Niatomi/portable-phone-osciloscope/README.md

# Portable Phone Osciloscope

Thesis on the creation of a portable USB oscilloscope.

Implemented electronic curcuit

Basicaly there is two mode:

1. Osciloscope mode

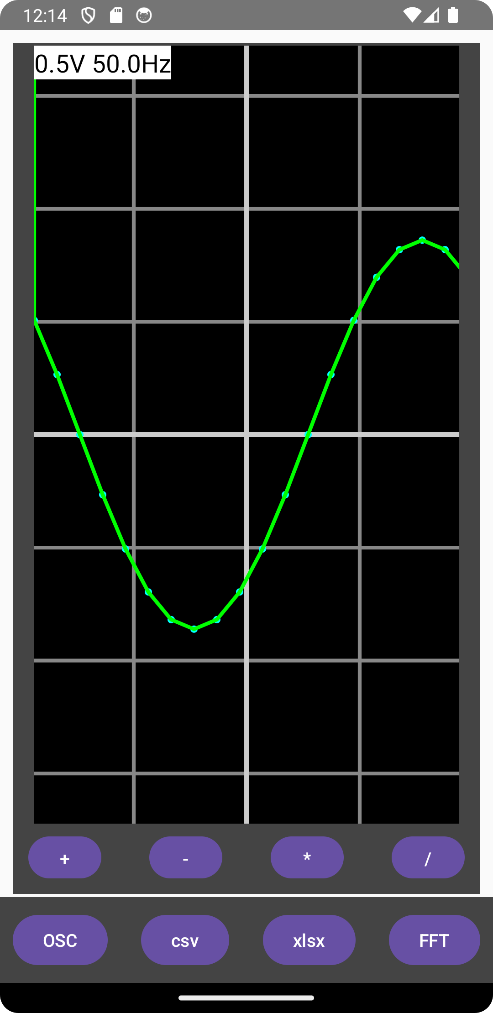
[picture p1: assets/1.png]
Osciloscope mode


2. FFT mode

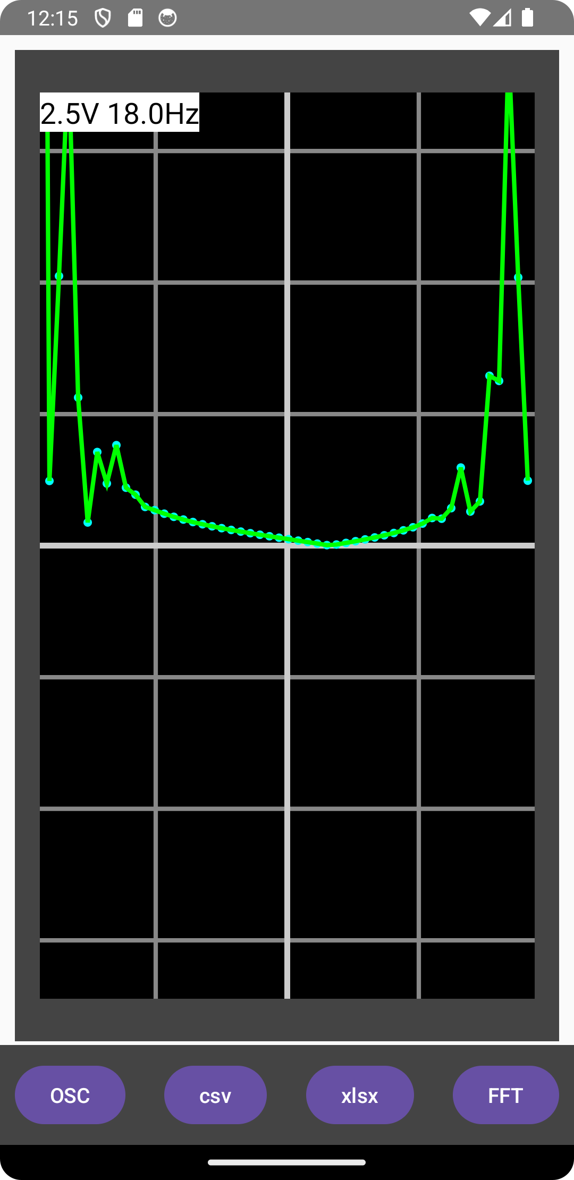
[picture p2: assets/2.png]
FFT mode
