Niatomi/portable-phone-osciloscope/logseq/pages/8.md

- https://dewesoft.com/ru/blog/types-of-adc-converters
  id:: 6646f040-7bf6-491e-b8a9-2d2daee1e0ae
