Niatomi/portable-phone-osciloscope/logseq/pages/Схема подключения микроконтроллера.md

- [[Схема подключения с измерительной цепью]]
- [[Схема подключения с UART преобразователем]]
