Niatomi/portable-phone-osciloscope/metrological-calculation/README.md

Первый делитель
1 / 2 = x * (10k / 20k)

Второй делитель
1 / 20 = V * (x / (10060  + x)) => x = 529.47
1 / 1 = V * ( 529.47 / (x  + 529.47)) => x = 0 (приравнять эту штуку к методической погрешности)

Третий делитель
https://www.ruselectronic.com/summator/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,%D0%9D%D0%B5%D0%B8%D0%BD%D0%B2%D0%B5%D1%80%D1%82%D0%B8%D1%80%D1%83%D1%8E%D1%89%D0%B8%D0%B9%20%D1%81%D1%83%D0%BC%D0%BC%D0%B0%D1%82%D0%BE%D1%80,-%D0%91%D0%B0%D0%B7%D0%BE%D0%B2%D0%B0%D1%8F%20%D1%81%D1%85%D0%B5%D0%BC%D0%B0%20%D0%B1%D1%83%D0%B4%D0%B5%D1%82

Максимальное входное напряжение - 0.5, максимальное выходное 1 В
Uвых = 1 В, U1 = 0.5, U2 = 0.5, R5 = 1 кОм
K1 = 1 / 1
K1 = R5 / x => R5 = 1 кОм

K2 = 1 / 10
K2 = R5 / x => x = 10 кОм

11 / 10 => R4 = 1100 Ом; R1 = 1000 Ом
