Niatomi/portable-phone-osciloscope/logseq/pages/DSO138.md

- DSO138 это карманный портативный осцилограф, который поставляется, либо в формате набора для самостоятельной сборки. Из плюсов такого подхода очевидная дешивизна, так как дополнительных затрат на сборку устройства компания не тратит.
- Максимум данное устройство может измерить 50 В сигнал с частотой дискретизации 200 кГц, что является плюсом, так как этих значений вплоне хватит для решения большиства задач при измерении напряжения [[17]].
- Из дополнительных функций DSO138 оборудован автоматической подстройкой пределов по частоте преобразования и входного напряжения.
- Питание устройства осуществляется при помощи внешнего источника питания на 9 В, либо при помощи блока питания, либо используя батарею крона. Поскольку DSO138 позиционируется как карманное решение, использование внешнего источника питания в данном случае является минусом, так как не всегда есть блок питания или даже доступ к источнику, а использование батарейки не делает практичным использование, так как её нужно заряжать зарядным устройством.
- Также осцилограф оборудован 2.4 дюма TFT экраном, который по нынешнем меркам является устревшим, как с позиции с технологии изготовления, так и с позиции восприятия данных, так как размер экрана того среднестатистического смартфона находится от 5 до 7 дюймов.
- На рисунке представлен собранный набор для осцилографа DSO138.
-
