Niatomi/portable-phone-osciloscope/logseq/pages/FNIRSI 1C15.md

- FNIRSI 1C15 является портативным универсальным осцилографом.
- Из выделяющихся опорных характеристик, на фоне рассмотренных осцилографов, он обладает полосой пропускания в 110 МГц, но при этом чуть меньшее максимальное входное напряжение в 40В [[20]].
- Из функций данное устройство может высчитывать в реальном времени статистические параметры, к примеру среднее значение, среднеквадратическое значение и т.д.. Но также стоит выделить странную реализацию сохранения сигнала, если в случае с [[DSO 068]] сигнал сохранялся в формат csv, который при дальнейшей обработке с использованием математических пакетов, довольно удобен при анализе и обраотке, то в FNIRSI 1C15 сохранение осуществляется путём записи картинки непосрдественно с TFT экрана, что в совокупности с его небольшими размерами и ручным переводом данных с картинки в число, не прибавляет удобства к использованию данного осцилографа
- Внешний вид FNIRSI 1C15 представлен на рисунке.
-
