Niatomi/portable-phone-osciloscope/logseq/pages/FNIRSI DPOX180H.md

- Двухканальный осциллограф FNiRSi DPOX180H сигнала позволяет отображать измеряемый сигнал в трех измерениях: амплитуда, время и интенсивность (распределение амплитуды по времени).
- Опорная характеристика полосы пропускания 180 МГц, максимальная величина входного напряжения 400В [[24]] .
- Для отобраения используется 2.5 TFT матрица
- Примечателен данный осцилограф тем, что на борту обладает функцией быстрого преобразования фурье, что позволяет получить спектр измеряемого сигнала.
- Внешний вид данного осцилографа представлен на рисунке.
-
