Niatomi/portable-phone-osciloscope/logseq/pages/HANTEK DSO-6074BC.md

- HANTEK DSO-6074BC осцилограф, который относится к классу устройств USB осцилографов, выполненных в форм факторе приставки.
- Относительно ранее рассмотренных осцилографов данное решение имеет довольно большие габариты 205 ммx 120 мм x 35 мм.
- Максимальное входное напряжение составляет 35 В, что не сравнимо даже с опорной характеристикой [[DSO138]], но при этом полоса пропускания составляет 70 МГц [[25]] .
- Данное устройство работает с приложением на внешнем устройстве. С которого можно производить фильтрацию, математические операции и т.д.. Такой подход является плюсом, так как нет привязки к дисплею.
-
