Niatomi/portable-phone-osciloscope/logseq/pages/OWON HDS2202S.md

- Осцилограф-мультиметр OWON HDS22002S в сравнении с предыдущими устройствами не выделяется широким набором функций для обработки сигнала. Из дополнительных функций в нём имеется только TrueRMS мультиметр и встроенный генератор сигналов специальной формы.
- Однако в сравненнии с ценовыми конкурентами его отличительной особенностью является наиболее широкая полоса пропускания, которая составляет 200 МГц, при максимальном напряжении входа 400 В [[23]].
- Внешний вид устройства представлен на рисунке
-
