Niatomi/portable-phone-osciloscope/logseq/pages/Квешенебл моментс.md

- ((663a9cfd-d353-4d09-9c25-ffef4bc72268)):
	- DONE [[Можно ли описать какие способы отладки использовались]]
	- DONE [[Можно ли в курсовой добавить объяснения почему выбран именно Android SDK, а не какой-то другой инструмент?]]
		- DONE [[К этому же вопросу, нужен ли анализ существующих инструментов типо React Native, Dart...]]
	- DONE [[Можно описывать ли описывать структуры хранения данных и паттерны]]
	- DONE [[Можно ли рассказать о формате передачи кадра?]]
	- DONE [[Можно ли в качестве источников использовать документацию к API?]]
		- Пример ссылки 133 страница - 134 источник - диссертация
		- ((663a7e74-4323-4b85-9dee-838098a09589))
	- DONE [[Можно ли добавить про инструменты разработки? (PlatformIO, Android Studio]]
	- DONE [[Можно ли описать структура проекта как файлы, типа, кто чем занимается, зачем нужен?]]
-
- ((663a9d09-63a3-4b8c-8e39-364c182f6277)):
	- DONE [[Можно ли в математику засунуть расчёт векторной графики для приложения?]]
	  id:: 663a7e74-4323-4b85-9dee-838098a09589
	  :LOGBOOK:
	  CLOCK: [2024-05-08 Wed 10:59:20]--[2024-05-08 Wed 10:59:21] =>  00:00:01
	  :END:
	- CANCELED [[Если приложение будет иметь несколько способов отображения (обычный осциллограф, функциональный вывод, АЧХ, фильтрация какойто составляющей) можно ли это внедрить в математику?]]
	  :LOGBOOK:
	  CLOCK: [2024-05-08 Wed 11:04:49]--[2024-05-08 Wed 11:04:50] =>  00:00:01
	  :END:
-
- Приложения код:
	- DONE Есть ли заготовка для таблицы с кодом?
		- Нет(
	- DONE Добавляем весь код или только тот, на который ссылаемся?
		- Какой угодно
	- На код можно сделать ссылку на гитхаб и показать во время защиты
-
- CANCELED [[Если мне нужно ввести свой собственный термин, как и куда?]]
  :LOGBOOK:
  CLOCK: [2024-05-08 Wed 01:27:14]--[2024-05-08 Wed 01:27:15] =>  00:00:01
  CLOCK: [2024-05-08 Wed 01:27:15]--[2024-05-08 Wed 01:27:16] =>  00:00:01
  :END:
	- DONE Так всё ещё можно как в предыдущей [методичке]([[Методичка]]) ?
	-
-
- [[Фактическая структура диплома]]
	- DONE [[Правильная ли структура литературного обзора?]]
	- DONE Ссылка на дальнейшее описание
		- Можно ли вот тут Описание делителя напряжения сделать ссылку, что о методах изменения входного напряжения будет описано далее?
		- Это го же касается  и
		- И соответственно про то что сигнал придётся брать по модулю через ОУ [схема модуля на ОУ](https://habr.com/ru/companies/ruvds/articles/652325/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)
		- Да
	- DONE В целом норм/не норм?
-
- CANCELED Что делать если в схеме несколько земель?
- CANCELED Слово ГОСТЫ можно в множественном числе? ((663fbce7-d2f5-4c2b-9e3c-d34130072230))
  :LOGBOOK:
  CLOCK: [2024-05-14 Tue 22:59:28]--[2024-05-14 Tue 22:59:28] =>  00:00:00
  CLOCK: [2024-05-14 Tue 22:59:29]
  :END:
	- DONE Сюда же вопрос, нужно ли этот момент пояснять, что я именно этими гостами пользовался?
- DONE Можно ли раскрыть более подробно тему работы, типо поставить тех задание?
- DONE [[Как оформить габаритный чертёж?]]
	- Вот это оформить с ссылкой на приложение или пофек можно и так картинкой оставить
	- ((6643b3d2-dbd5-4664-a6b5-57d0a078e533))
-
- DONE Мы руские друг друга в дюймах измеряем или в сантиметрах? ((66472a2f-47ac-4026-a4d5-c7771bc563bf))
	- Переводим в санитметры
- DONE Как оформить приложение для [печатной платы]([[Печатная плата]]) и нужно ли оно вообще как приложение?
	- Нужно показать на А3 все слои платы
- DONE Как обозначать вид общий именно где цифры?
	- И в методичке про это написано (или вк)
	- https://vk.com/im?sel=c142#:~:text=10%3A44-,%D0%A8%D0%B8%D1%84%D1%80%20%D0%B2%20%D1%87%D0%B5%D1%80%D1%82%D0%B5%D0%B6%D0%B0%D1%85,-%D0%BF%D1%80%D0%B8%D0%B2%D0%BE%D0%B4%D0%B8%D1%82%D1%81%D1%8F%20%D0%B2%20%D1%84%D0%BE%D1%80%D0%BC%D0%B0%D1%82%D0%B5
	- СамГТУ 12.03.01 040 015 003 (ноиер листа) ВО
- DONE На структурную можно ведь вывести предохранительную обвязку [[Разработка структурной схемы]]
	- DONE Здесь же вопрос, atmega328P работает на 20 MHz, максимальная частота АЦП 200 МГц, но между ними есть регистровый буфер, это ведь имеет смысл?
	- CANCELED STM32 посавить плату или ESP32
	- Просто нужно указать, что часть кадров может быть утеряна
- CANCELED Когда последняя дата сдачи последней бюрократии?
	- 26 мая
-
