Niatomi/portable-phone-osciloscope/logseq/pages/Методы обработки цифровых сигналов.md

- Одним из важных методов при обработке цифровых сигналов является преобразование Фурье. Преобразование Фурье переводит дискретный или непрерывный сигнал из временной в частотную область (по оси x вместо времени t следует откладывать частоту ω), причем полученные коэффициенты имеют комплексный вид. Модуль этих коэффициентов показывает распределение амплитуд по частотам в сигнале, а аргумент – распределение фазовых сдвигов по частотам [[10]].
-
