Niatomi/portable-phone-osciloscope/logseq/pages/План капкан.md

- DONE Проработать [[Формат передачи данных]]
- DONE Реализовать Serial подлючение к телефону
- DONE Сделать обёрточные функци под байтовый фрейм
- DONE  [#A] [[Реализовать базовый компонент отрисовки данных формата XY]]
  :LOGBOOK:
  CLOCK: [2024-05-07 Tue 23:32:21]--[2024-05-07 Tue 23:32:23] =>  00:00:02
  CLOCK: [2024-05-07 Tue 23:32:24]--[2024-05-07 Tue 23:32:25] =>  00:00:01
  :END:
- TODO  [#A] Реализовать алгоритмы отображения сигнала
	- DONE Осцилограф
	- DONE АЧХ
	- TODO Фильтрация составляющией
- DONE [#B] Переделать схему для работы с отрицательными сигналами
	- DONE Принципиальная схема
	- DONE Спецификация
- DONE [#C] В соответсвии с этой схемой сделать ультра мелкую плату в [Dip Trace](https://diptrace.com/rus/)
	- DONE [#C] Для этой схемы сделать корпус
- TODO [#C] БЮРОКАРААААТИИИЯЯЯ
	- DONE [[Титульный лист]]
	- DONE [[Реферат]]
	- DONE [[Введение]]
	- DONE [[Теоретическое исследование портативный устройств измерения временных сигналов]]
		- DONE [[Литературный обзор]]
		- DONE [[Итог анализа литературного обзора]]
		- DONE [[Постановка задачи]]
	- DONE [[Разработка методики измерения параметров временных сигналов в цифровой электронике]]
		- DONE [[Преобразование аналогового сигнала в цифровой]]
		- DONE [[Способы изменения масштаба дискретизации]]
		- DONE [[Метод изменения входного напряжения]]
		- DONE [[Методы смещения сигнала]]
		- DONE [[Методы обработки цифровых сигналов]]
		  :LOGBOOK:
		  CLOCK: [2024-05-16 Thu 20:41:56]--[2024-05-16 Thu 20:41:56] =>  00:00:00
		  CLOCK: [2024-05-16 Thu 20:41:57]--[2024-05-16 Thu 20:41:57] =>  00:00:00
		  CLOCK: [2024-05-16 Thu 20:41:57]--[2024-05-17 Fri 12:51:39] =>  16:09:42
		  :END:
		- DONE [[Порядок действий обработки аналогового сигнала]]
	- TODO [[Разработка портативного устройства для измерения параметров временных сигналов]]
		- DONE [[Постановка задачи]]
		- DONE [[Разработка структурной схемы]]
		  :LOGBOOK:
		  CLOCK: [2024-05-12 Sun 16:35:29]--[2024-05-12 Sun 16:35:30] =>  00:00:01
		  :END:
		- DONE [[Разработка принципиальной схемы]]
		- DONE [[Разработка печатной платы]]
		  :LOGBOOK:
		  CLOCK: [2024-05-12 Sun 17:07:12]--[2024-05-14 Tue 22:58:23] =>  53:51:11
		  :END:
			- DONE Сделать плату в DipTrace
			- DONE Написать текст
			  :LOGBOOK:
			  CLOCK: [2024-05-14 Tue 04:10:12]
			  :END:
		- DONE [[Разработка корпуса устройства]]
			- DONE Сделать корпус
			- DONE Написать текст
		- DONE [[Разработка математического обеспечения]]
		- TODO [[Разработка программного обеспечения]]
		- TODO [[Эксперементальное исследование разработанного устройства]]
	- DONE [[Заключение]]
	- TODO [[Список использованных источников]]
	- TODO [[Приложения]]
		- DONE [[Принципиальная схема]]
		- DONE [[Перечень элементов]]
		- DONE [[Печатная плата]]
		- DOING [[Корпус]]
		  :LOGBOOK:
		  CLOCK: [2024-05-17 Fri 14:13:02]
		  :END:
		- TODO [[Исходный код]]
