Niatomi/portable-phone-osciloscope/logseq/pages/Порядок действий обработки аналогового сигнала.md

- На основе всего описанного выше, для обработки аналогового сигнала следует соблюсти последовательность преобразования измерямой величины:
	- Преобразовать измерямый сигнал к пределу измерения аналогового-цифрового преобразователя, используя связку делитель с сумматором;
	  logseq.order-list-type:: number
	- Настроить масштаб частоты дискретизации под частоту измеряемого сигнала;
	  logseq.order-list-type:: number
	- Преобразованный сигнал при помощи АЦП перевести в цифровое дискретное значение;
	  logseq.order-list-type:: number
	- Получение значение передать на устройство ввода/вывода, где содержится вся серия дискретных данных;
	  logseq.order-list-type:: number
