Niatomi/portable-phone-osciloscope/logseq/pages/Разработка математического обеспечения.md

- [[Реализация представления кадра данных]]
- [Алгоритм отрисовки данных]([[XYCanvas]])
- [[Реализация АЧХ представления сигнала]]
