Niatomi/portable-phone-osciloscope/logseq/pages/Схема подключения с UART преобразователем.md

- Для взаимодействие с внешними устройствами к миконтроллеру подключен преобразователь интерфейсов FT232RL, подключение к которому осуществляется при помощи штекерный вывод micro USB.
- FT232RL позволяет переводит данные с интерфеса UART микронтроллера на USB, так и обратно. Внешнее подключаемое устройство помимо обмена данных с ESP-12S будет также осуществлять функцию источника питания, через тот же интерфейс USB
- Также плата имеет кнопку SB1, которая перезагрузит микроконтроллер. Отключение платы осуществляется либо физическим способом, путём отключения устройства, либо программным - отключение функции OTG на уровене внешнего подключаемого устройства.
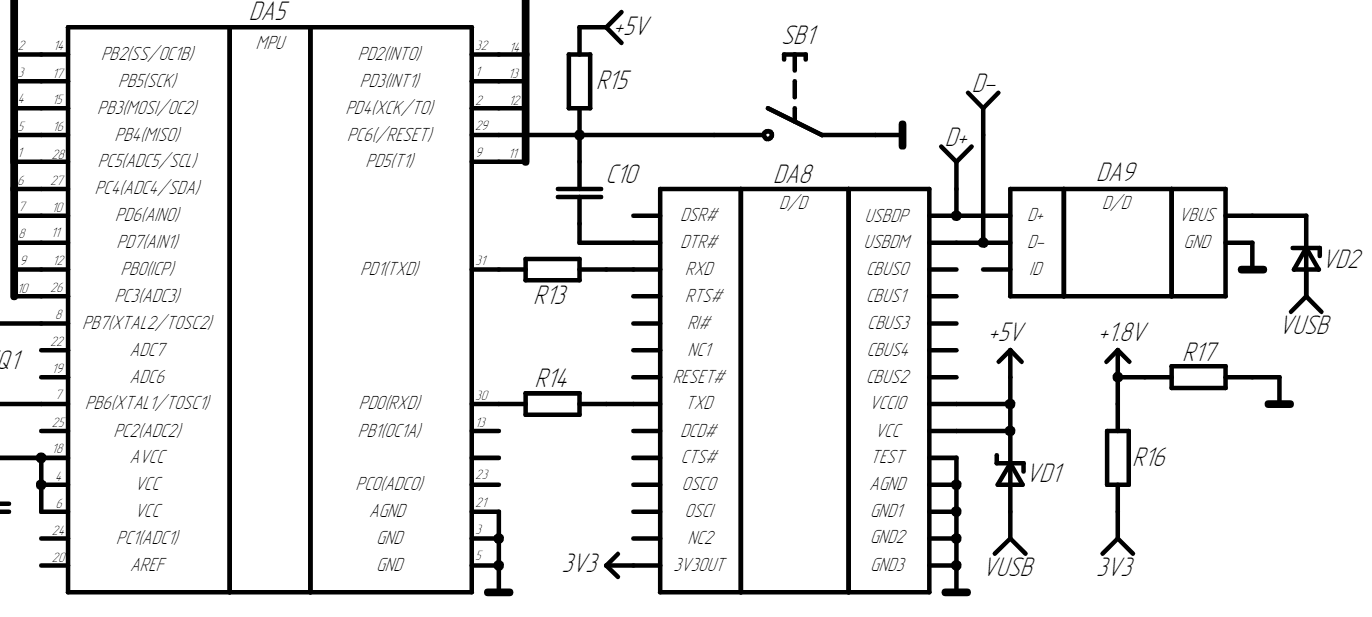
[picture p6: logseq/assets/image_1715514424193_0.png]
-
