Niatomi/portable-phone-osciloscope/logseq/pages/DSO 068.md

- Портативный карманный осцилограф от ранее рассмотренной компании, хоть и имеет модельное обозначение меньше, чем рассмотренные осцилографы, но при этом является более мощной с точки зрения опорных характеристик.
- Его максимальная частота полосы пропускания составляет 3 МГц, при этом максимальное входное напряжение зависит от щупа. С щупом 1:1 максимальное входное напряжение составляет 50 В, а при использовании щупа 1:10 оно возрастает до 400 В [[21]] .
- Использующийся здесь жидкокристалический дисплей явно самый худший из рассмотренных, к тому же он составляет всего 2 дюйма. Но представление данных в этом устройстве не ограничивается одним лишь экраном, ведь измеряемые данные можно записать на устройстве и перенести в формате CSV на компьютер.
- Также из минусов устройство имеет большие габариты, они составляют 140мм X 70мм X 30мм
- Внешний вид DSO 068 представлен на рисунке.
- JYE Tech DSO068 Oscilloscope DIY Kit
