Niatomi/portable-phone-osciloscope/logseq/pages/DSO-TC2.md

- DSO-TC2 является мультифункциональным цифровым осцилографом. В данном устройстве реализовано множество инструментов через интрефейсные разъёмы, к примеру ШИМ-генератор, ZIF-панель, вольтметр MMXC и т.д.
- Здесь уже используется встроенная литиевая батарея на 1500 мАч, что является плюсом.
- Величина полосы пропускания частот осталась на равне с ранее рассмотренными моделями, но при этом увеличилась максимальная амплитуда напряжения до 400 В [[19]].
- Но проблема использования той же самой 2.4 TFT матрицы никуда не делась.
- Внешний вид DSO-TC2 представлен на рисунке.
-
