Niatomi/portable-phone-osciloscope/logseq/pages/Итог анализа литературного обзора.md

- Проанализровав все основные решения в поставленном ценовом диапазоне, выявлены опорные характеристики, которые свойственны осцилографам на текущий момент.
- Для полосы пропускания минимальное значение составляет 200 кГц, максимальная 200 МГц. Устройства обладающие полосой пропускания больше 200 МГц относятся к классу лабораторных осцилографов, которые соответственно имеют большую стоимость, поэтому в данном разделе они не были упомянуты.
- Для входного напряжения сигнала предел варьируется между 50 В и 400 В.
- Общий минус, применимый к каждому из устройств, связан с маленьким размером и качеством матрицы отображения данных. Диагональ экрана преимущественно обладает размером 2.4 дюйма, а сами матрицы выполнены по технологии TFT. Поэтому пользовательский опыт в таком случае оставляет желать лучшего.
- Часть из рассмотренных решений, обладает полезными функциями, например быстрое преобразование Фурье, математические функции над сигналами или экспорт в удобный формат. Такие функции бывают крайне полезны при измерении сигналов.
- Также на примере осцилографа от Hantek можно увидеть, что использование измерительной схемы без использования интерфейсов ввода/вывода встроенных непосредственно в устройство вполне применимо, взамен их в качестве интерфейса взаимодействия выступает внешнее устройство.
