Niatomi/portable-phone-osciloscope/logseq/pages/Литературный обзор.md

- На данный момент на рынке портативных осцилографов представлено множество уже готовых решений. Различаются они набором функционала и соответственно чем выше цена устройства, чем больше функций оно имеет на борту. Рассматриваемые в данной главе устройстве находятся в пределе ценовой стоимости до 20000 рублей на момент написания данной выпускной квалификационной работы. Именно такой диапазон выбран потому что данная ценовая категория наиболее востребована и по итогу разработанное устройство должно составить конкуренцию в данном сегменте.
-
- [[DSO138]]
- [[DSO Shell]]
- [[DSO-TC2]]
- [[DSO 068]]
- [[FNIRSI 1C15]]
- [[MiniDSO DS211]]
- [[FNIRSI DPOX180H]]
- [[OWON HDS2202S]]
- [[HANTEK DSO-6074BC]]
