Niatomi/portable-phone-osciloscope/logseq/pages/Постановка задачи.md

- На основании всех решений уже имеющихся на момент написания выпускной квалификационной работы следует составить техническое задание, которое наложит ограничения на измеряемую величину, технические характиристики и особенности взаимодействия.
- Основополагающая идея разрабатываемого устройства заключается в портативности и компактности. Данной цели возможно добится используя следующие пункты:
	- Устройство должно использовать внешнее устройство ввода/вывода для отображения данных;
	- Это же внешнее устройство должно использоваться в качестве источника питания
	- Компоненты измерительной системы должны быть компактными и энергоэффективными
	- Габаритные размеры полученного устройства не должны превышать размеры среднестатистического смартфона, что в районе от 5 до 7 дюймов.
	  id:: 66472a2f-47ac-4026-a4d5-c7771bc563bf
- На измеряемый сигнал также имеются следующие ограничения:
	- Абсолютная величиная напряжения должна быть меньше 100 В, так как не предполагается использовать разрабатываемый осцилограф, в целях измерения силовой электроники, где обычное напряжение составляет более 100 В.
	- Частота сигнала должна быть не более 200 МГц.
- На программном уровне должны быть реализованы следующие функции:
	- Представление сигнала;
	- Представление спектра сигнала;
	- Применение математических функций к полученным данным;
	- Импортирование измеренных данных в форматы CSV/XLSX;
- Также для структурированной и согласованной работы между устройством пользователя и измерительной системой следует создать единую структру передачи дискретного отсчёта.
