Niatomi/portable-phone-osciloscope/logseq/pages/1.md

- И.Н. Зайцева, Э.И. Исакович, Н.А. Ярлыкова Радиоизмерения и измерительные приборы: осциллографы. Осциллографические измерения: учебно-методическое пособие. – Елец: Елецкий государственный университет им. И.А. Бунина, 2017. – 96 с
  id:: 66463b8e-3c2d-447e-8e59-d44b0099ba4c
