Niatomi/portable-phone-osciloscope/logseq/pages/10.md

- Преобразование измерительных сигналов: практикум / А.В. Бочкарев, Р.Т. Сайфуллин. – Самара: Самар. гос. техн. ун-т, 2022. – 150 с.
  id:: 66471382-ade9-4dab-a1d1-b92a50d67d31
