Niatomi/portable-phone-osciloscope/logseq/pages/11.md

- Статья http://www.dspa.ru/articles/year2019/jour19_2/art19_2_10.pdf
  id:: 6647180b-f64a-4029-9207-7c54a19812c4
