Niatomi/portable-phone-osciloscope/logseq/pages/2.md

- М 47 Цифровые измерительные устройства. Часть 1. – Аналогоцифровые преобразователи: Учеб. пособ. / В.С. Мелентьев, П.К. Ланге, К.Л. Куликовский. – Самара: Самар. гос. техн. ун-т, 2012. – 209 с.: ил.
  id:: 6646e34e-37ec-49d5-8227-cade29b075a3
