Niatomi/portable-phone-osciloscope/logseq/pages/3.md

- Одинец А.И., Науменко А.П. Цифровые устройства: АЦП и ЦАП: Учеб. пособие. – Омск: Изд-во
  id:: 6646e461-7db6-4322-9953-b1678678ca85
  ИРСИД, 2006.- 48 с.
