Niatomi/portable-phone-osciloscope/logseq/pages/5.md

- Аналого-цифровые и цифроаналоговые преобразователи: методические указания к выполнению лабораторной работы по дисциплине «Электротехника, электроника и схемотехника» / ЮгоЗап. гос. ун-т; сост. В.И. Иванов. - Курск: ЮЗГУ, 2016. 19 е.: ил. 11,табл. 1.-Библиогр.: с. 19.
  id:: 6646e88e-c93c-440d-bcad-268af000d553
