Niatomi/portable-phone-osciloscope/logseq/pages/6.md

- Кестер, У. Аналого-цифровое преобразование / У. Кестер. – М.: Техносфера, 2007. – 1015 с.
  id:: 6646ec3b-90fb-4aae-9b18-e733c07c461a
