Niatomi/portable-phone-osciloscope/logseq/pages/7.md

- Ратхор Т.С. Цифровые измерения. АЦП/ЦАП / Пер. с англ. – 2-е изд., доп. – М.:
  id:: 6646eea2-9a7b-45a2-8508-e902b2bde6a2
  Техносфера, 2006. – 391 с.
