Niatomi/portable-phone-osciloscope/logseq/pages/Введение.md

- В данной выпускной квалификационной работе рассматривается разработка портативного устройства для измерения параметров временных сигналов, предназначенного для использования в связке с пользовательским устройством ввода/вывода, по типу телефона или планшета.
- Устройство для измерения параметров временных сигналов относится к категории измерительных приборов – осциллографы.
- Сами осциллографы делятся на две подкатегории – цифровые, аналоговые [[1]].
- Различие их заключается в способе обработки сигнала, в аналоговых осциллографах все преобразования над сигналом происходят напрямую при помощи сборки электронных блоков, их недостатки – ограниченные возможности по обработке и низкая точность. У цифровых за обработку отвечает чаще всего связка аналогово-цифрового преобразователя, захватывающего значение
  сигнала в определённые интервалы времени, а обработка этих значений происходит
  при помощи программного обеспечения микроконтроллера, их минусом является
  большая стоимость по отношению к аналоговым осциллографам.
- Применение осциллографов универсально – от использования при ремонте бытовой техники до анализа радиоэлектронных компонентов, поэтому осциллографы довольно широко распространены в сфере электротехники.
