Niatomi/portable-phone-osciloscope/logseq/pages/Печатная плата.md

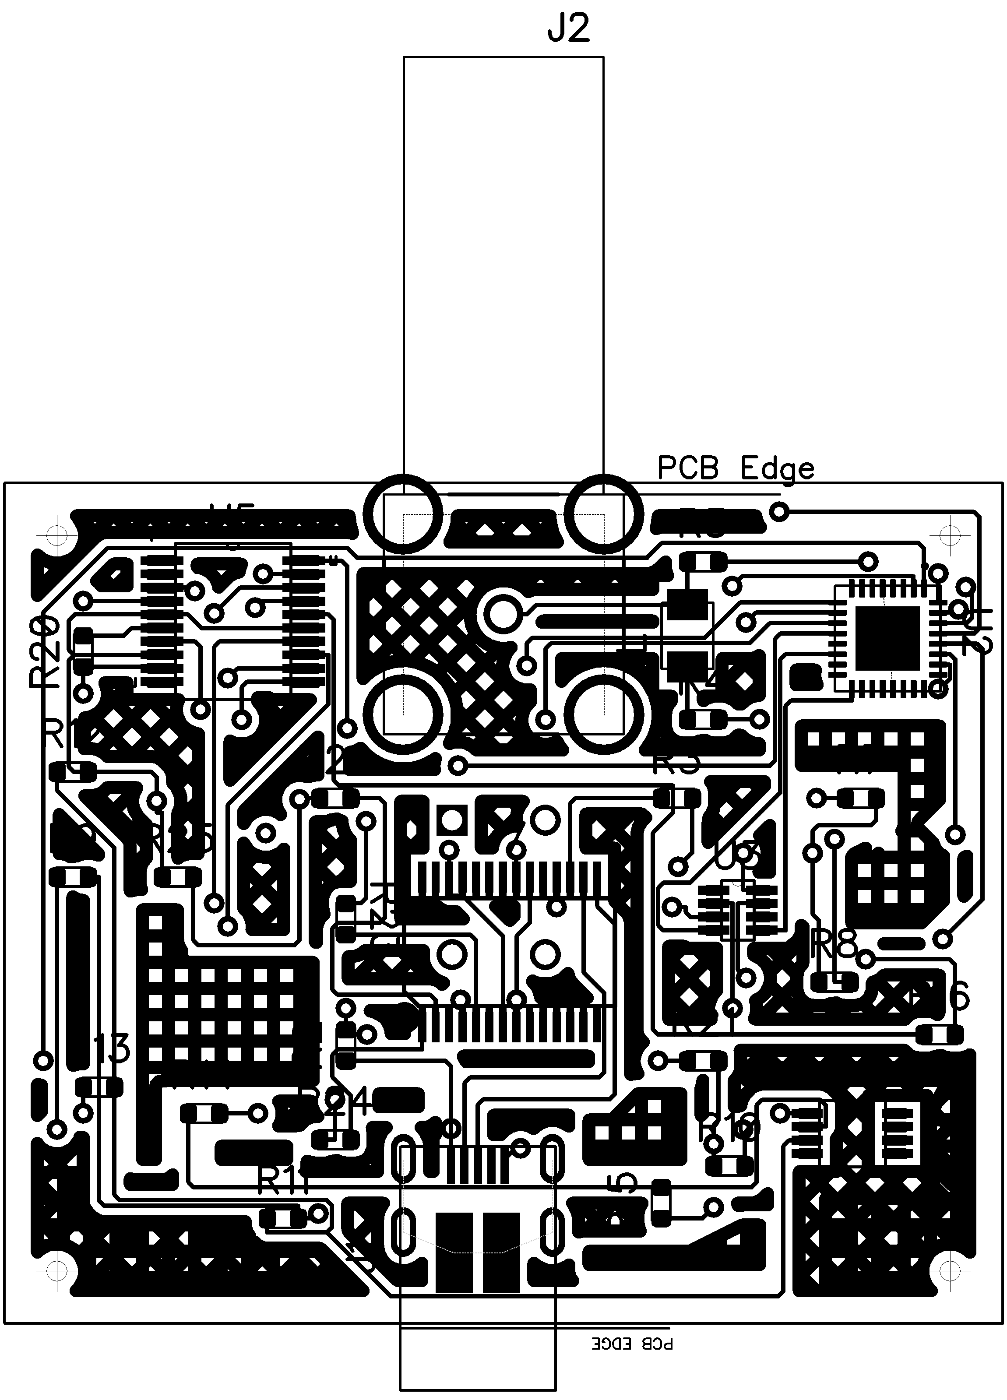
[picture p11: logseq/assets/Печатная_плата_1715940428006_0.png]
Печатная плата.png
-
