Niatomi/portable-phone-osciloscope/logseq/pages/Принципиальная схема.md

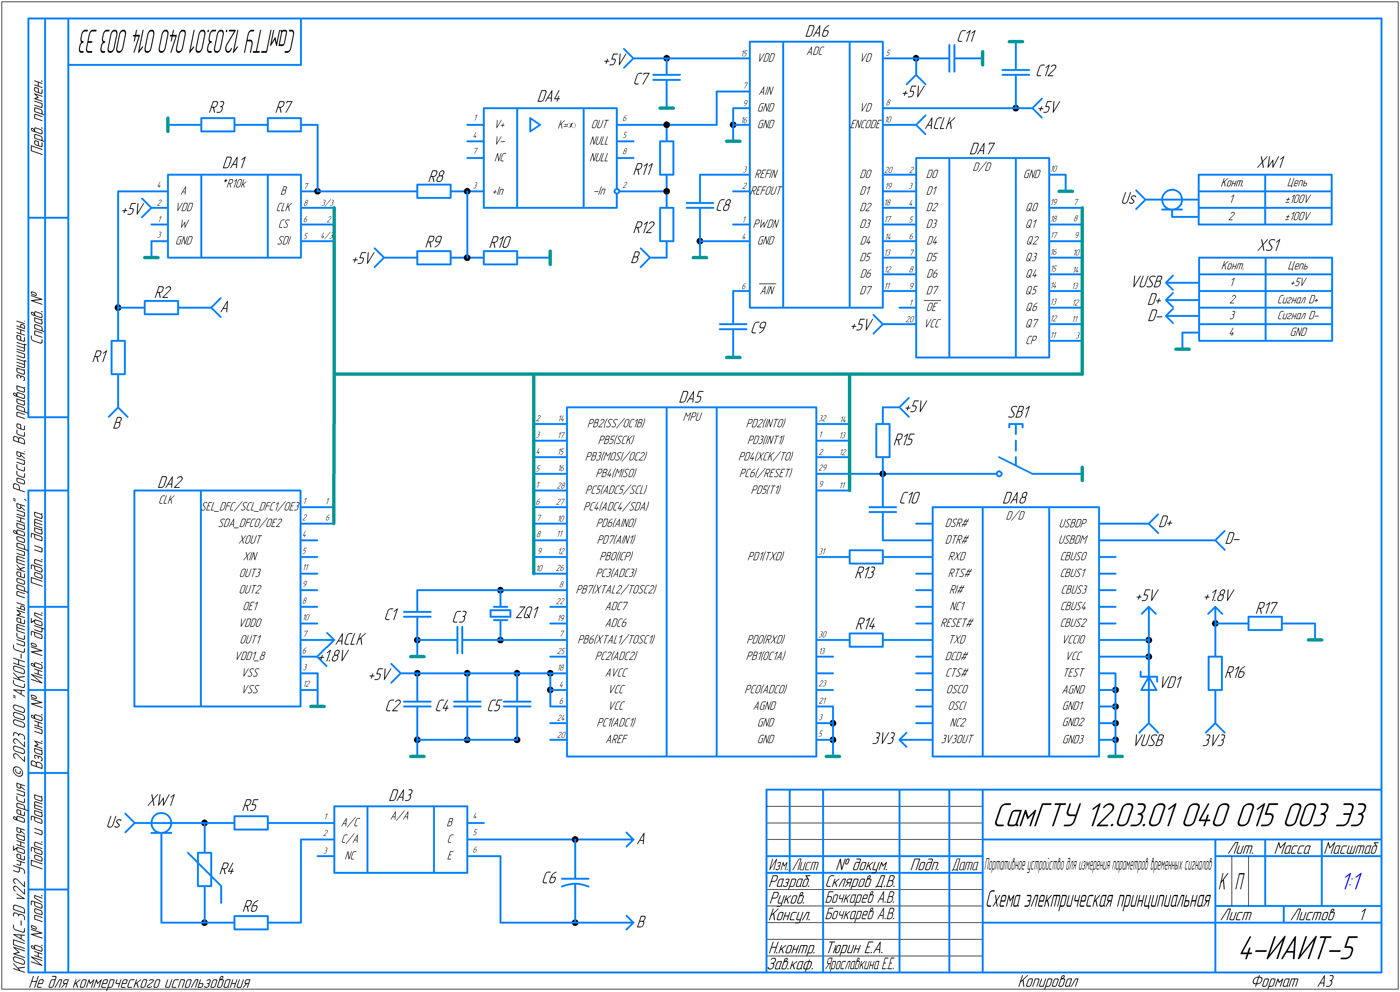
[picture p12: logseq/assets/Принципиальная_схема_1715940993965_0.png]
Принципиальная схема.png
-
