Niatomi/portable-phone-osciloscope/logseq/pages/Реферат.md

- Выпускная квалификационная работа _ страниц, _ рисунка, _ таблицы, _ источников, _ приложения, _ формулы.
-
- АНАЛОГОВО-ЦИФРОВОЙ
  ПРЕОБРАЗОВАТЕЛЬ, МИКРОКОНТРОЛЛЕР, ОБРАБОТКА СИГНАЛОВ, ОСЦИЛОГРАФ, ПОРТАТИВНОЕ
  УСТРОЙСТВО, СИГНАЛЫ
-
- Целью курсового проекта является разработка портативного устройства для измерения параметров временных сигналов.
- 3. [[Разработка портативного устройства для измерения параметров временных сигналов]]
- В первой части выпускной квалификационной работы преставлено теоретическое исследование похожих на разрабатываемое устройство решений.
- Во второй части описана методика измерения параметров временных сигналов в цифровой электронике
- Третья часть включает в себя процесс разработки устройства.
