Niatomi/portable-phone-osciloscope/logseq/pages/Структура взаимодействия.md

- В структуре взаимодействия микроконтроллера и клиентского приложения самым слабым, с точки зрения вычислительных мощностей, является микроконтроллер. Поэтому он будет реализовывать функции устройства, которое проксирует АЦП и выдаёт данные на выход [[15]] .
- Так как передаваемые данные очень важны для действительного представления данных пользователю, то выбрана следующий [[Формат передачи данных]] и сама единица данных.
