Niatomi/portable-phone-osciloscope/logseq/pages/Фактическая структура диплома.md

- Тема: Портативное устройство для измерения параметров временных сигналов
-
- [[Титульный лист]]
- [[Реферат]]
- [[Введение]]
- [[Содержание]]
- 1. [[Теоретическое исследование портативный устройств измерения временных сигналов]]
	- [[Литературный обзор]]
	- [[Итог анализа литературного обзора]]
	- [[Постановка задачи]]
- 2. [[Разработка методики измерения параметров временных сигналов в цифровой электронике]]
	- [[Преобразование аналогового сигнала в цифровой]]
	- [[Способы изменения масштаба дискретизации]]
	- [[Метод изменения входного напряжения]]
	- [[Методы смещения сигнала]]
	- [[Методы обработки цифровых сигналов]]
	- [[Порядок действий обработки аналогового сигнала]]
- 3. [[Разработка портативного устройства для измерения параметров временных сигналов]]
	- [[Разработка структурной схемы]]
	- [[Разработка принципиальной схемы]]
	- [[Разработка печатной платы]]
	- [[Разработка корпуса устройства]]
	- [[Разработка математического обеспечения]]
	  id:: 663a9d09-63a3-4b8c-8e39-364c182f6277
	- [[Разработка программного обеспечения]]
	  id:: 663a9cfd-d353-4d09-9c25-ffef4bc72268
	- [[Эксперементальное исследование разработанного устройства]]
	  id:: 663a995f-07b6-4ca6-892e-067e713fab81
- [[Заключение]]
- [[Список использованных источников]]
- [[Приложения]]
	- Принципиальная схема
	- Перечень элементов
	- [[Печатная плата]]
	- [[Корпус]]
	- Исходный код
