Niatomi/portable-phone-osciloscope/logseq/pages/Как оформить габаритный чертёж%3F.md

- Отдельно по три вида на каждую часть для приложений
- И в рисунках можно это добавить как демонстрацию габаритов
