Niatomi/portable-phone-osciloscope/logseq/pages/Разработка принципиальной схемы.md

- CANCELED Для реализации принципиальной схемы устройства используется Компас 22 версии. В качестве стандарта условных графических обозначений используются ГОСТ 2.743-91 и ГОСТ 2.755-87.
  id:: 663fbce7-d2f5-4c2b-9e3c-d34130072230
-
- [[Схема входной обвязки]]
- [[Схема входных делителей]]
- [[Схема подключения аналогово-цифрового преобразователя]]
- [[Схема подключения микроконтроллера]]
