Niatomi/portable-phone-osciloscope/logseq/pages/Apache Cordova.md

- Среда разработки мобильных приложений запускает обработку JavaScript/HTML/CSS кода в WebView и добавляет системные вызовы для взаимодействия со специфичными для определённых операционных систем интерфейсами.
- Данная платформа на данный момент не поддерживается создателем, но всё ещё популярна и используется в таким продуктах как [1C-Битрикс](https://dev.1c-bitrix.ru/learning/course/index.php?COURSE_ID=80&LESSON_ID=7757).
- Экспериментальное использование [Serial библиотеки](https://github.com/WolfWalter/cordova-plugin-usb-serial) выявило, что пример из документации для этой библиотеки не работает на новых версиях Android.
