Niatomi/portable-phone-osciloscope/logseq/pages/Ionic и PhoneGap.md

- Ionic и PhoneGap являются ответвлениями проекта Apache Cordova cо значительными доработками под новые версии Android и iOS.
- Идентичные эксперименты с Serial библеотеками, как в случае Apache Cordova, не привели к каким-либо положительным резльутатам. Приложения также не запускались, либо инициализировались, но без соединения с микроконтроллером.
