Niatomi/portable-phone-osciloscope/logseq/pages/Jetpack Compose.md

- Jetpack Compose инструмент является нативным SDK для Android устройств, но также исходный код ПО может быть скомпилирован под iOS устройства.
- Так как это нативный инструмент разработки взаимодействие с устройствами Serial порта на Android устройствах происходят напрямую через [TTY](https://itsfoss.com/what-is-tty-in-linux/) обращаемого устройства.
- Сам инструмент поддерживается как компанией разработчиком Google, так и сообществом.
- В ходе экспериментов с Serial портом минусов при отладке не выявлено. Данный SDK корректно прошёл все этап экспериментальной программы.
