Niatomi/portable-phone-osciloscope/logseq/pages/React Native.md

- React Native SDK для создания кроссплатформенных приложений, благодаря которой написанное ПО будет работать как и на устройствах под управлением операционной системы Anroid, так и на устройствах под управлением iOS.
- Сам инструмент поддерживается компанием разработчиком и мировым сообществом, об этом говорит колличество и периодичность выхода новых версий на [странице релизов](https://github.com/facebook/react-native/releases)
- Эксперимент с использованием библиотеки [Serial порта](https://www.npmjs.com/package/serialport) с примером из документации в React Native выявил, что подключение к микроконтроллеру срабатывает с некоторой периодичностью, а само приложение после установления соединения начинает нестабильно работать.
