Niatomi/portable-phone-osciloscope/logseq/pages/Заключение.md

- Можно основать на заключении курсовой, НО дополнить результатами исследования 2 главы (какой метод или алгоритмы обработки были выбраны для разрабатываемой системы), а также дополнениями (если они возникли) по сравнению с курсовой из 3 главы (если делали печтаную плоту - можно указать ее гарабирты, если корпус - тоже габариты и особенности)
-
- Данная работа была направлена на разработку gортативного устройства для измерения параметров временных сигналов. В работе были описаны общие принципы дискретного и аналогово измерения сигналов при помощи осциллографов. Описаны основные компоненты, использующиеся при построении осциллографов, а именно делители, аналогово-цифровые преобразователи, мультиплексоры, буферные регистры, а также интерфейсы вывода данных пользователю.  Создана и описана структурная схема разработанного устройства. Реализована принципиальная электрическая схема устройствадля анализа сигналов, способного работать с поддерживающими USB устройствами.  Спроектирована печатная плата на основе принципиальной, а также создан корпус устройства.
