Niatomi/portable-phone-osciloscope/logseq/pages/Схема подключения с измерительной цепью.md

- Шина на которой подключены все управляемые устройства ведётся к микроконтроллеру, с которого и ведётся всё дальнейшее чтение данных с буферного регистра и управление периферийными устройствами.
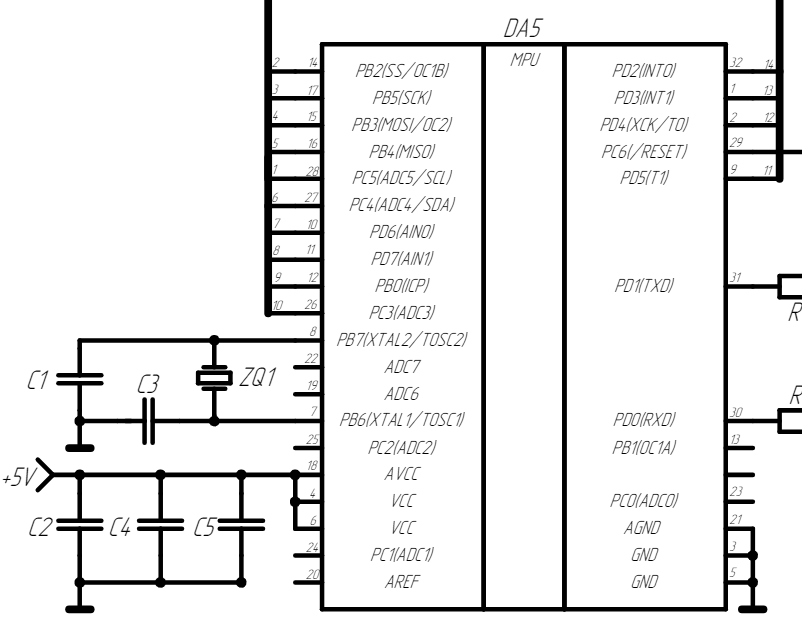
[picture p29: logseq/assets/image_1715514192946_0.png]
- 
-
