Niatomi/portable-phone-osciloscope/logseq/pages/Если мне нужно ввести свой собственный термин, как и куда%3F.md

- [[Фрейм]]
-
- Если нужно ввести свой собственный термин, на него можно сделать описание непосрдественно в тексте
-
