Niatomi/portable-phone-osciloscope/logseq/pages/Можно ли в математику засунуть расчёт векторной графики для приложения%3F.md

- Можно описать с позиции развертки осцилографа
