Niatomi/portable-phone-osciloscope/logseq/pages/Можно ли описать структура проекта как файлы, типа, кто чем занимается, зачем нужен%3F.md

- Можно, но не чтоб половина всего текста ))
