Niatomi/portable-phone-osciloscope/logseq/pages/Правильная ли структура литературного обзора%3F.md

- Пример в диссере - 22 страница
- В целом это не регламентировано
- Если нужно сослаться на товар, то можно ссылкой на сайт сделать отсылку на товар
-
- `hantek` вот эти устройства сюда можно
- `LCard` быстодействующий АЦП``
