Niatomi/portable-phone-osciloscope/logseq/pages/Разработка ПО микрокнтроллера.md

- Исходный код ПО для микроконтроллера написан на языках программирования С и C++.
- При разработке ПО для микроконтроллера был выбран инструмент [PlatformIO](https://platformio.org/), который во многом упрощает работу со сторонними библиотеками, что поможет возможной вариативности компонентов АЦП.
