Niatomi/portable-phone-osciloscope/logseq/pages/Разработка программного обеспечения.md

- [[Разработка ПО микрокнтроллера]]
- [[Разработка ПО клиентского приложения]]
- [[Структура взаимодействия]]
- [[Создание и отладка ПО при разработке]]
