Niatomi/portable-phone-osciloscope/logseq/pages/Создание и отладка ПО при разработке.md

- В качестве инструмента [[Разработка ПО микрокнтроллера]] использовалась среда разработки vscode и отладчик gdb
- В качестве инструмента [[Разработка ПО клиентского приложения]] использовался Android Studio и встроенный в него отладчик
