Niatomi/portable-phone-osciloscope/logseq/pages/PhoneClient.md

## Клиентское приложение просмотра измерений
id:: 663a8778-5327-4917-97cb-f06bf426e31d
- [[Общие положения для подпроекта для клиентского приложения]]
-
- [[./java/.../phoneclient]]
