Niatomi/portable-phone-osciloscope/logseq/pages/ProxyADCApp.md

## Проксирующее АЦП приложение для микроконтроллера
id:: 663a87a4-aab0-4c55-b605-84bffbf7fc4b
- [[Общие положения для подпроекта для микроконтроллера]]
-
- [[src]] - Исходный код
-
