Niatomi/portable-phone-osciloscope/logseq/pages/screens.md

- Каждый скрин представляется из себя читателя [[RingBuffer]]
- Преобразование над данными фрейма производятся только внутри структур данных скрина
	- Изменять данные непосредственно в кольцевом буфере !!НЕЛЬЗЯ
	-
