Niatomi/portable-phone-osciloscope/logseq/pages/Выбор (или разработка) методики изменеия (или обработки) %5F%5F%5F (название измеряемого параметра, или видов обработки и т.п.).md

- Пример:
	- Выбор методики измерения расстояния
	- Разработка методики обработки сигналов в ___ (название разрабатываемой системы)
-
- В этом разеделе говорим (не обязательно по обоим пунктам):
	- Методы (или методики) (и/или разработанные самостоятельно метод) измерения интересующего нас параметра, т.е. схема подключения устройства, порядок действий для получения нужного параметра из измеряемого сигнала.
		- Пример: Для дальномера это может быть формулы расчёта расстояния по задержке звука при различных способах - теневом, это и т.д..
	- Существующее (или собственное) математическое обеспечение, алгоритмы, программное обеспечение для обработки сигналов в классе устройств, к которому относится разрабатываемое система.
		- Если вы моделируете в Ansys процесс получения измеряемой величины без учёта параметров (абстрактно, для проверки каких-то рассмотренных методик измерения их физико-математической основы и т.п.) без конкретных элементов из вашего устройства (волновод определённой формы и т.п.), то его пихаем сюда
-
