Niatomi/portable-phone-osciloscope/logseq/pages/Источники информации.md

- Сервисы для поиска:
	- [Google Scholar](https://scholar.google.com/) - для статей (рус англ)
	- [elibrary](https://elibrary.ru/defaultx.asp?) - для статей (но некоторые ссылки google scholar) требует бесплатной регистрации, не все стаьи можно открыть бесплатно
	- [CyberLeninka](https://cyberleninka.ru/) - без реги, все статьи доступны
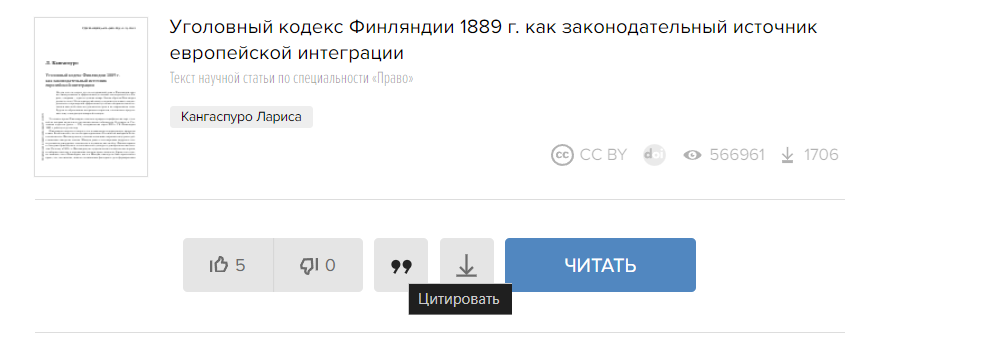
[picture p30: logseq/assets/image_1714199571545_0.png]
		- 
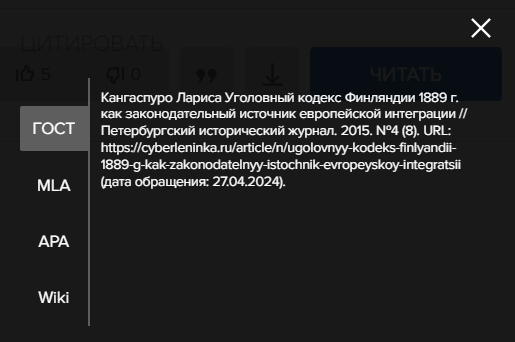
[picture p31: logseq/assets/image_1714199580018_0.png]
		- 
		- Взрыв мозга
	- [Яндекс.Патент](https://yandex.ru/patents) - для поиска патентов СССР, РФ
	- [Google patents](https://patents.google.com/) - для пендоских
	- [Sci Hub](https://sci-hub.hkvisa.net) - для профессиональных воришек
