Niatomi/portable-phone-osciloscope/logseq/pages/Можно ли в качестве источников использовать документацию к API%3F.md

- Как пример https://developer.android.com/reference/kotlin/android/graphics/Canvas
