Niatomi/portable-phone-osciloscope/logseq/pages/Общие положения для подпроекта для клиентского приложения.md

- Структурой хранения данных на устройстве является [[RingBuffer]]
- Основным способом отрисовки является [[XYCanvas]]
-
-
