Niatomi/portable-phone-osciloscope/logseq/pages/Общие положения для подпроекта для микроконтроллера.md

- Проект реализован на PlatformIO
- [[ADCPayload]] - [[Фрейм]]
