Niatomi/portable-phone-osciloscope/logseq/pages/Разработка %5F%5F%5F (название разрабатываемой системы).md

- 2 и 3 разделы и курсовой работы
-
- Можно здесь разработать печатную плату и корпус разрабатываемой системы
- (потребуется добавить чертежи в приложения)
- Желательно показать работу в `multisim`
- Если Ansys применяется для выбора оборудования или тестирования работы разработанных элементов.
- Если проводились реальные измерения разработанной системой - тоже сюда (последний параграф, название примерно "Эксперементальное исследование разработанной ")
