Niatomi/portable-phone-osciloscope/logseq/pages/Спецификация фрейма для данного проекта.md

- На вход ацп максимально подаваемое напряежение - 5В
- Точность 4 знака после запятой
- Большая точность в случае c ATmega328 не имеет смысла, так как битность у данного микроконтроллера слабая, из-за чего при преобразовании к формату фрейма теряется часть данных
-
- Структура фрейма
- ```bash
  // 0 - frame version
  // 1 - reserved
  // 2 - reserved
  // 3 - positive (1) or negative (0)
  // 4 - integer part
  // 5 - 1..2 of decimal part
  // 6 - 3..4 of decimal part
  // 7 - reserved
  ```
-
- 0  байт нужен для избежания проблем с совместимости прошивки и клиента
	- В случае если приложение не умеет рабоать с таким форматом кадра - выбросит ошибку
	- В случае более старой версии фрейма - всё ещё будет рабоать в режиме обратной совместимости
- 1 и 2 - байты зарезервированы под тайминговые параметры (в случае если измерительная способность АЦП выше, чем скорость передачи через серийник)
	- В этом случае передача может быть осуществлена не по-фреймово, а по серии фреймов
	- Хранение же таких данных может быть в кольцевом буфере на уровне миекр
- 7 - байт зарезервирован для АЦП большей точности
