Niatomi/portable-phone-osciloscope/logseq/pages/Струтура диплома.md

- [[Методичка]]
-
- [Тоже самое только вордом](https://docs.google.com/document/d/1TTPFvkdmokORthcByouCCN4abKgXnVY24xoW2qqHQk8/edit#heading=h.s4ydd44yrill)
-
- Общий объём ВКР - 60+ страниц
- Лучше регулировать свои страницы
- Титульник, реферат, введнеие, содержание - 5-7 страниц
-
- 1. [[Теоретическое исследование (тип класс разрабатываемого устройства устройства)]] 10-15 страниц
- 2. [[Выбор (или разработка) методики изменеия (или обработки) ___ (название измеряемого параметра, или видов обработки и т.п.)]] 10-15 страниц
- 3. [[Разработка ___ (название разрабатываемой системы)]] 15-30 страниц
- 4. [[Заключение]] 1-2 страницы
- 4. [[Источники информации]] ~~
- 5. [[приложения (схема перечень, алгоритмы?, код программы?, чертеж корпуса?, печатная плата?)]] ~~
