Niatomi/portable-phone-osciloscope/logseq/pages/Теоретическое исследование (тип класс разрабатываемого устройства устройства).md

- Первое что нужно сделать, определить сделал кто-то это или нет. Для этого делаем литературный обзор страниц на 10-15. В конце этого раздела можно сделать параграф (подраздел) с выводами - какие из обозрённых устройств, техник, технологий, методов и т.д. сейчас актуальны, какие могут быть у них проблемы и т.п.. Сформивароть утверждение о том, какие из рассмотренных техник, технологий и т.д. вы считтаете разумным использовать при проектировании собственной системы.
  title:: Теоретическое исследование (тип класс разрабатываемого устройства устройства)
