Niatomi/portable-phone-osciloscope/logseq/pages/Формат передачи данных.md

## Определение
- [[Фрейм]] - это байтовый массив, который является представлением одного дискретно взятого измерения. Фрейм являеся транспортной единицей информации.
- [[Спецификация фрейма для данного проекта]]
- После измерения фрейм передаётся сразу на Serial Port
-
