Niatomi/portable-phone-osciloscope/logseq/logseq/.recycle/pages_Фактическая структура проекта.md

- [[Титульный лист]]
- [[Реферат]]
- [[Введение]]
- [[Содержание]]
-
