Niatomi/portable-phone-osciloscope/logseq/logseq/bak/pages/Фактическая структура диплома/2024-05-16T14_43_19.651Z.Desktop.md

- Тема: Портативное устройство для измерения параметров временных сигналов
-
- [[Титульный лист]]
- [[Реферат]]
- [[Введение]]
- [[Содержание]]
- 1. [[Теоретическое исследование портативный устройств измерения временных сигналов]]
	- [[Литературный обзор]]
		- [[Пункт литературного обзора]]
			- Краткое описание
			- Плюсы/минусы
		- ...
		- [[Пункт литературного обзора]]
			- Краткое описание
			- Плюсы/минусы
		- [[Итог анализа литературного обзора]]
			- Подитог самых лучших к использованию
			- [[Постановка задачи]]
- 2. [[Разработка методики измерения параметров временных сигналов в цифровой электронике]]
	- [[Преобразование аналогового сигнала в цифровой]]
		- Описание принципа работы АЦП
			- Либо с изменением опорного напряжения
				- Этот вариант не подойдёт так как трансформатор и портативность противоречят друг другу
			- Либо с изменением входного напряжения
				- Описание делителя напряжения
				  id:: 663a933b-f5da-4ea0-a2fb-e9e48a157804
			- Так как все мелкие одноканальные АЦП не могут в неоднополярные сигналы пишем про смешение сигнала
			  id:: 663a9442-8992-446d-bc4c-ab29d0bf4bc3
			- Также нужно описать какие характеристики опорные
		- [[Способы изменения масштаба дискретизации]]
		- [[Метод изменения входного напряжения]]
			- Вот тут уже пишем про делители
		- [[Методы смещения сигнала]]
			- про компараторы
		- [[Методы обработки цифровых сигналов]]
			- Прямое представление
				- В паре слов про то x(t)
			- АЧХ
				- Тут про преобразование Фурье
			- Фильтрация
				- Тут про нерекурсивные фильтры и про эффект Гиббса
		- [[Порядок действий обработки аналогового сигнала]]
			- На основе всего выше перечисленного сигнал нужно
			- Изменить до предела АЦП -> sum(a, b) -> adc(sig) -> микроконтроллер -> метод цифровой обработки
- 3. [[Разработка портативного устройства для измерения параметров временных сигналов]]
	- [[Разработка структурной схемы]]
	- [[Разработка принципиальной схемы]]
		- Указать тип
	- [[Разработка печатной платы]]
	- [[Разработка корпуса устройства]]
	- [[Разработка математического обеспечения]]
	  id:: 663a9d09-63a3-4b8c-8e39-364c182f6277
	- [[Разработка программного обеспечения]]
	  id:: 663a9cfd-d353-4d09-9c25-ffef4bc72268
	- [[Эксперементальное исследование разработанного устройства]]
	  id:: 663a995f-07b6-4ca6-892e-067e713fab81
- [[Заключение]]
- [[Список использованных источников]]
- [[Приложения]]
	- Схема
	- Перечень
	- Плата
	- Корпус
	- Код
	-
