Niatomi/portable-phone-osciloscope/logseq/logseq/bak/pages/План капкан/2024-05-16T14_43_19.645Z.Desktop.md

- DONE Проработать [[Формат передачи данных]]
- DONE Реализовать Serial подлючение к телефону
- DONE Сделать обёрточные функци под байтовый фрейм
- TODO  [#A] [[Реализовать базовый компонент отрисовки данных формата XY]]
  :LOGBOOK:
  CLOCK: [2024-05-07 Tue 23:32:21]--[2024-05-07 Tue 23:32:23] =>  00:00:02
  CLOCK: [2024-05-07 Tue 23:32:24]--[2024-05-07 Tue 23:32:25] =>  00:00:01
  :END:
- TODO  [#A] Реализовать алгоритмы обработки сигнала
	- TODO Осцилограф
	- TODO АЧХ
	- TODO Фильтрация составляющией
- DONE [#B] Переделать схему для работы с отрицательными сигналами
	- DONE Принципиальная схема
	- TODO Спецификация
- DONE [#C] В соответсвии с этой схемой сделать ультра мелкую плату в [Dip Trace](https://diptrace.com/rus/)
	- DONE [#C] Для этой схемы сделать корпус
- TODO [#C] БЮРОКАРААААТИИИЯЯЯ
	- DONE [[Титульный лист]]
	- TODO [[Реферат]]
	- TODO [[Введение]]
	- TODO [[Теоретическое исследование портативный устройств измерения временных сигналов]]
	- TODO [[Разработка методики измерения параметров временных сигналов в цифровой электронике]]
		- TODO [[Преобразование аналогового сигнала в цифровой]]
			- TODO [[Способы изменения масштаба дискретизации]]
			- TODO [[Метод изменения входного напряжения]]
			- TODO [[Методы смещения сигнала]]
			- TODO [[Методы обработки цифровых сигналов]]
			- TODO [[Порядок действий обработки аналогового сигнала]]
	- TODO [[Разработка портативного устройства для измерения параметров временных сигналов]]
		- DONE [[Постановка задачи]]
		- DONE [[Разработка структурной схемы]]
		  :LOGBOOK:
		  CLOCK: [2024-05-12 Sun 16:35:29]--[2024-05-12 Sun 16:35:30] =>  00:00:01
		  :END:
		- DONE [[Разработка принципиальной схемы]]
		- DONE [[Разработка печатной платы]]
		  :LOGBOOK:
		  CLOCK: [2024-05-12 Sun 17:07:12]--[2024-05-14 Tue 22:58:23] =>  53:51:11
		  :END:
			- DONE Сделать плату в DipTrace
			- DONE Написать текст
			  :LOGBOOK:
			  CLOCK: [2024-05-14 Tue 04:10:12]
			  :END:
		- DONE [[Разработка корпуса устройства]]
			- DONE Сделать корпус
			- DONE Написать текст
		- TODO [[Разработка математического обеспечения]]
		- TODO [[Разработка программного обеспечения]]
		- TODO [[Эксперементальное исследование разработанного устройства]]
	- DONE [[Заключение]]
	- TODO [[Список использованных источников]]
	-
-
	-
