Niatomi/portable-phone-osciloscope/бюрократия/Курсовая/Презентация.pptx

## Презентация устройства по теме: «УСТРОЙСТВО ДЛЯ АНАЛИЗА СИГНАЛОВ»

МИНОБРНАУКИ РОССИИ
Федеральное государственное бюджетное
учреждение
высшего образования
«Самарский государственный технический университет»
(ФГБОУ ВО «СамГТУ»)

Презентацию выполнил:
студент 4-ИАИТ-5
Скляров Д.В.

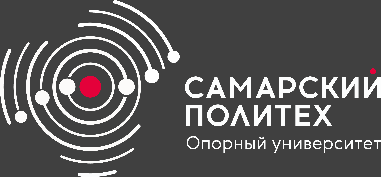
[picture p32: figure]
logo-rus1_

Самара 2023

## Цель и задачи презентации

- Представление принципиальной схем;
- Подведение перечня элементов;
- Представление инструментальной погрешности;

## Цель и задачи презентации

- Представление принципиальной схем;
- Подведение перечня элементов;
- Представление инструментальной погрешности;

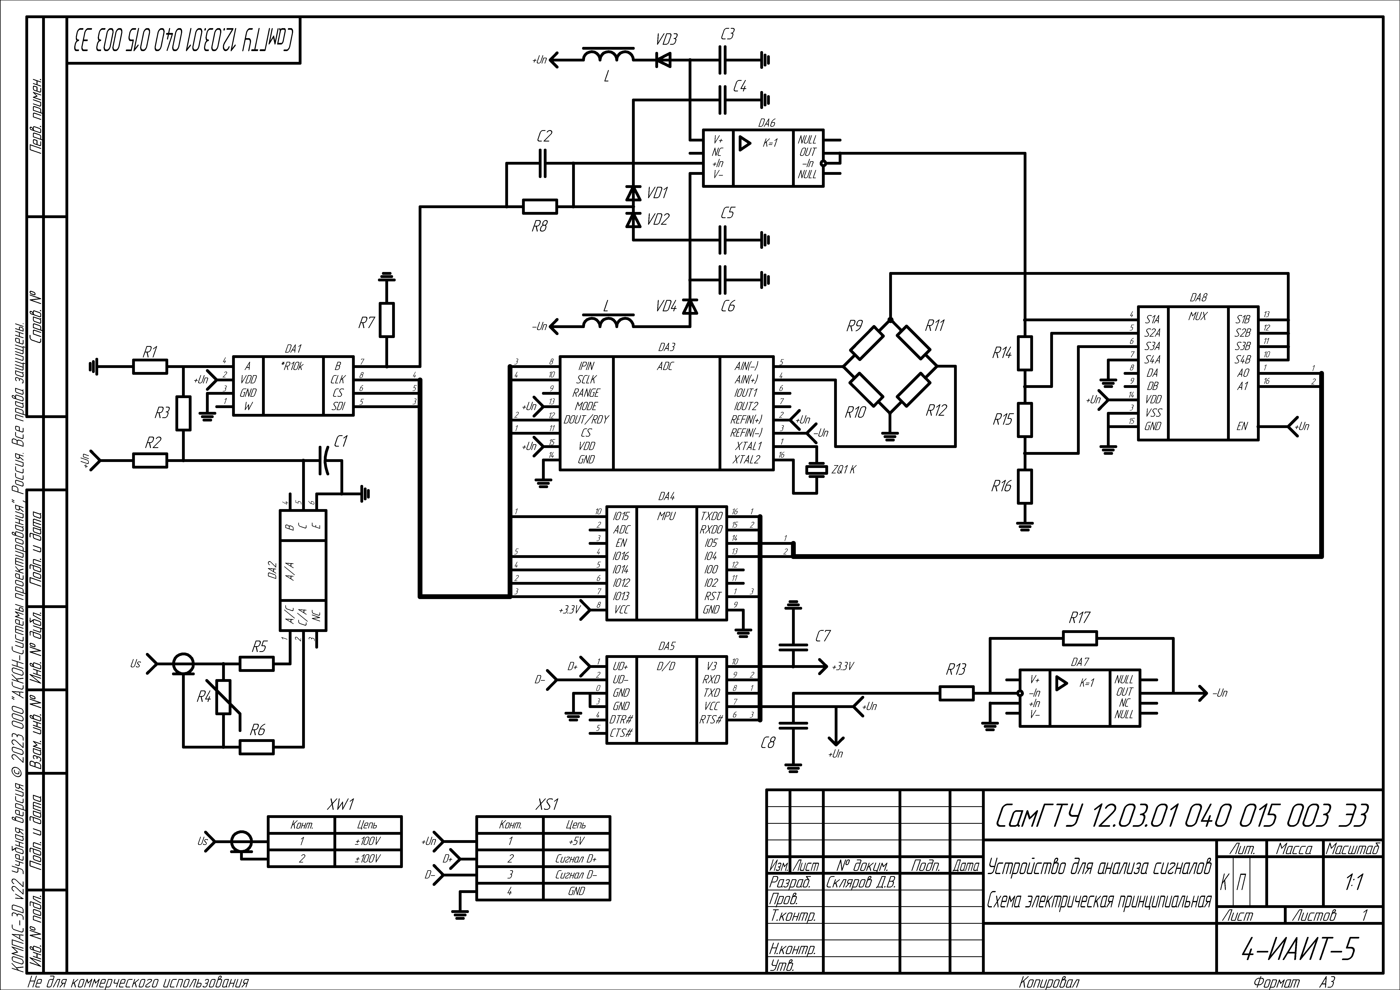
[picture p33: figure]

## Slide 4

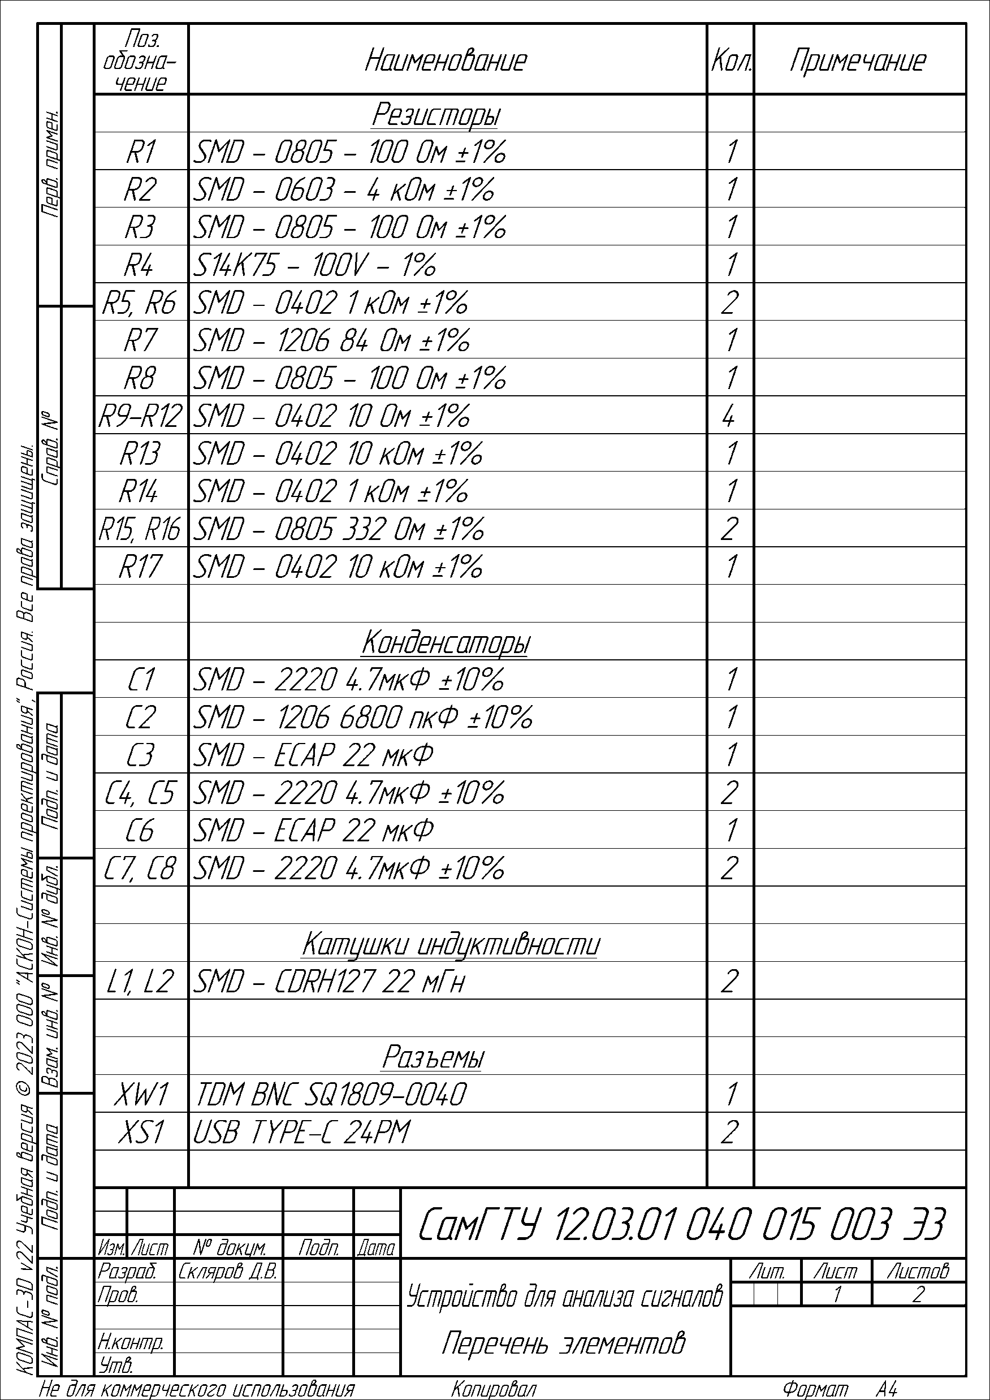
[picture p34: figure]
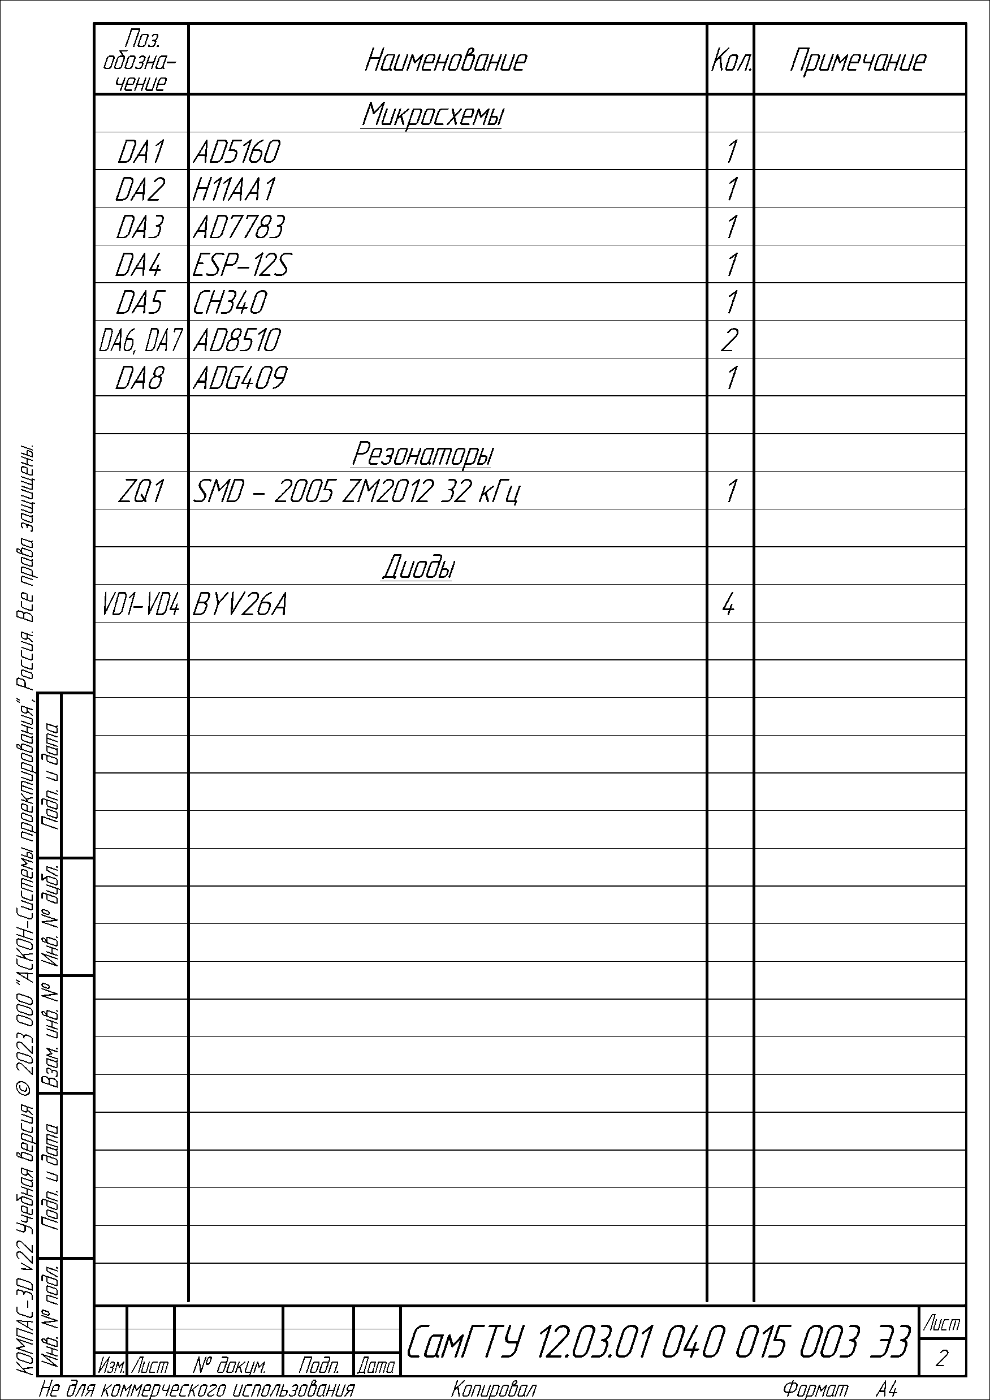
[picture p35: figure]

## Спасибо за внимание

## Спасибо за внимание
