Niatomi/portable-phone-osciloscope/бюрократия/Курсовая/Спецификация.pdf

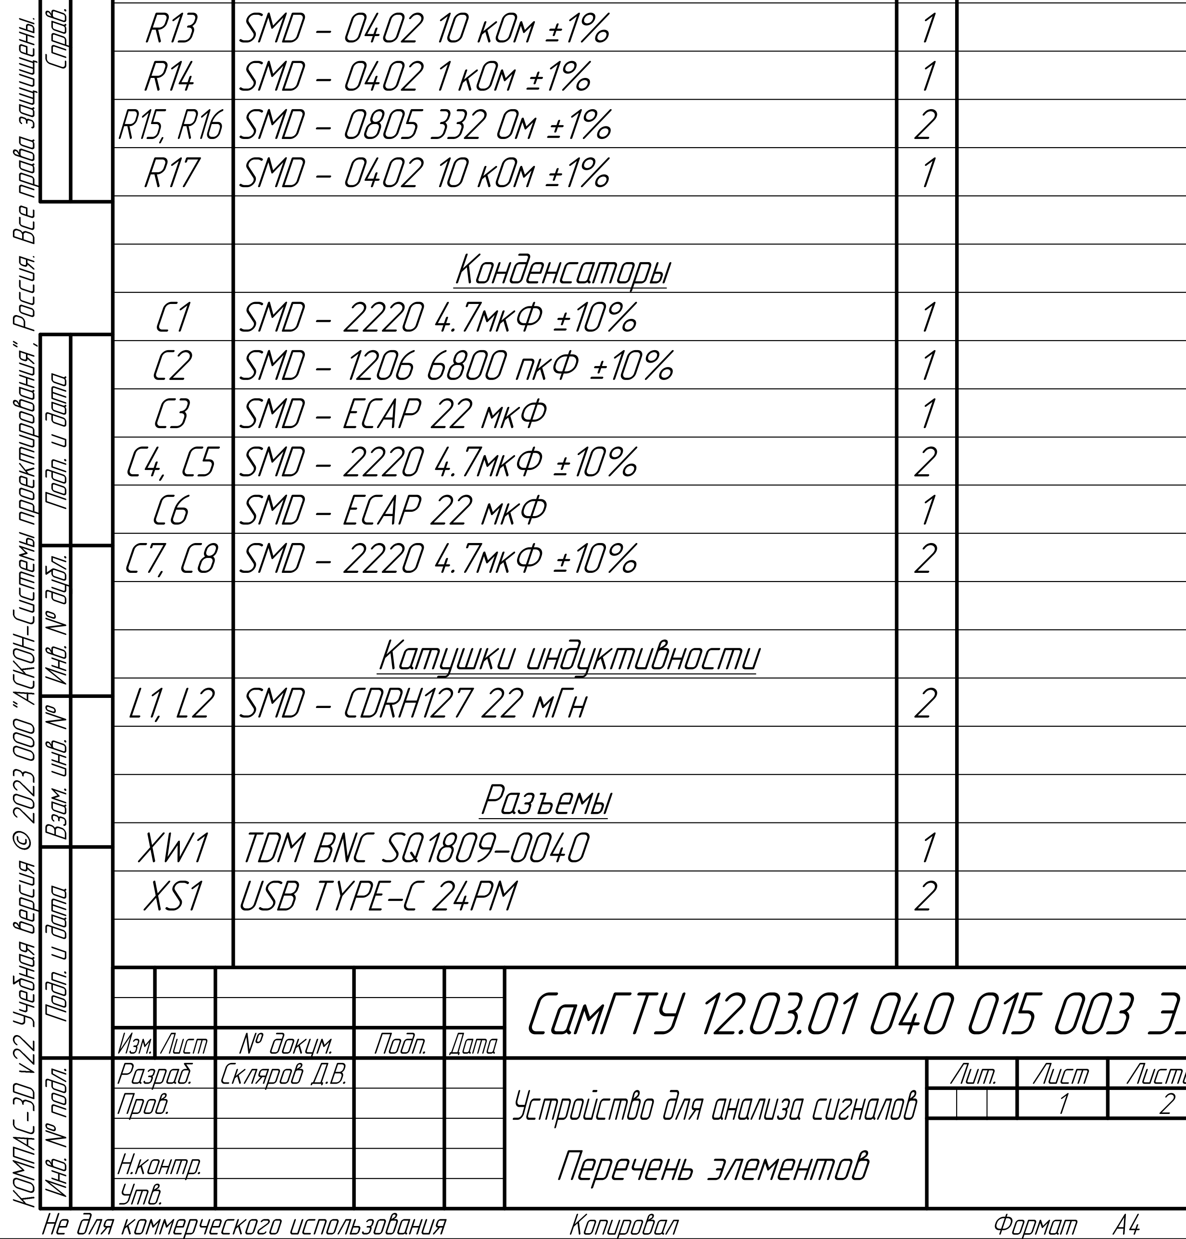
[picture p36: figure]
Пров.; SMD - 0402 10 кОм ±1%; SMD - 0402 1 кОм ±1%; R15, R16 SMD - 0805 332 Ом ±1%; Конденсаторы; SMD - 2220 4.7мкФ ±10%; SMD - 1206 6800 пкФ ±10%; SMD - ECAP 22 мкФ; C4, C5 SMD - 2220 4.7мкФ ±10%; C7, C8 SMD - 2220 4.7мкФ ±10%; Катушки индуктивности; L1, L2 SMD - CDRH127 22 мГн; Разъемы; TDM BNC SQ1809-0040; USB TYPE-C 24PM; Копировал; Формат A4

| № докум. | Подп. | Дата | СамГТУ 12.03.01 040 015 003 Э3 Изм. Лист
| Разраб. | Скляров Д.В. | | | Устройство для анализа сигналов Перечень элементов | Лит. | Лист | Листов
Н.контр. Инв. № подл. Подп. и дата Взам. инв. № Инв. № дубл. Подп. и дата | Утв. Справ. № Перв. примен. | Резисторы
R1 | SMD - 0805 - 100 Ом ±1% | 1
R2 | SMD - 0603 - 4 кОм ±1% | 1
R3 | SMD - 0805 - 100 Ом ±1% | 1
R4 | S14K75 - 100V - 1% | 1
R5, R6 SMD - 0402 1 кОм ±1% | | 2
R7 | SMD - 1206 84 Ом ±1% | 1
R8 | SMD - 0805 - 100 Ом ±1% | 1
R9-R12 SMD - 0402 10 Ом ±1% | | 4

Поз.
обозначение
Наименование | Кол. Примечание

## СамГТУ 12.03.01 040 015 003 Э3 Лист

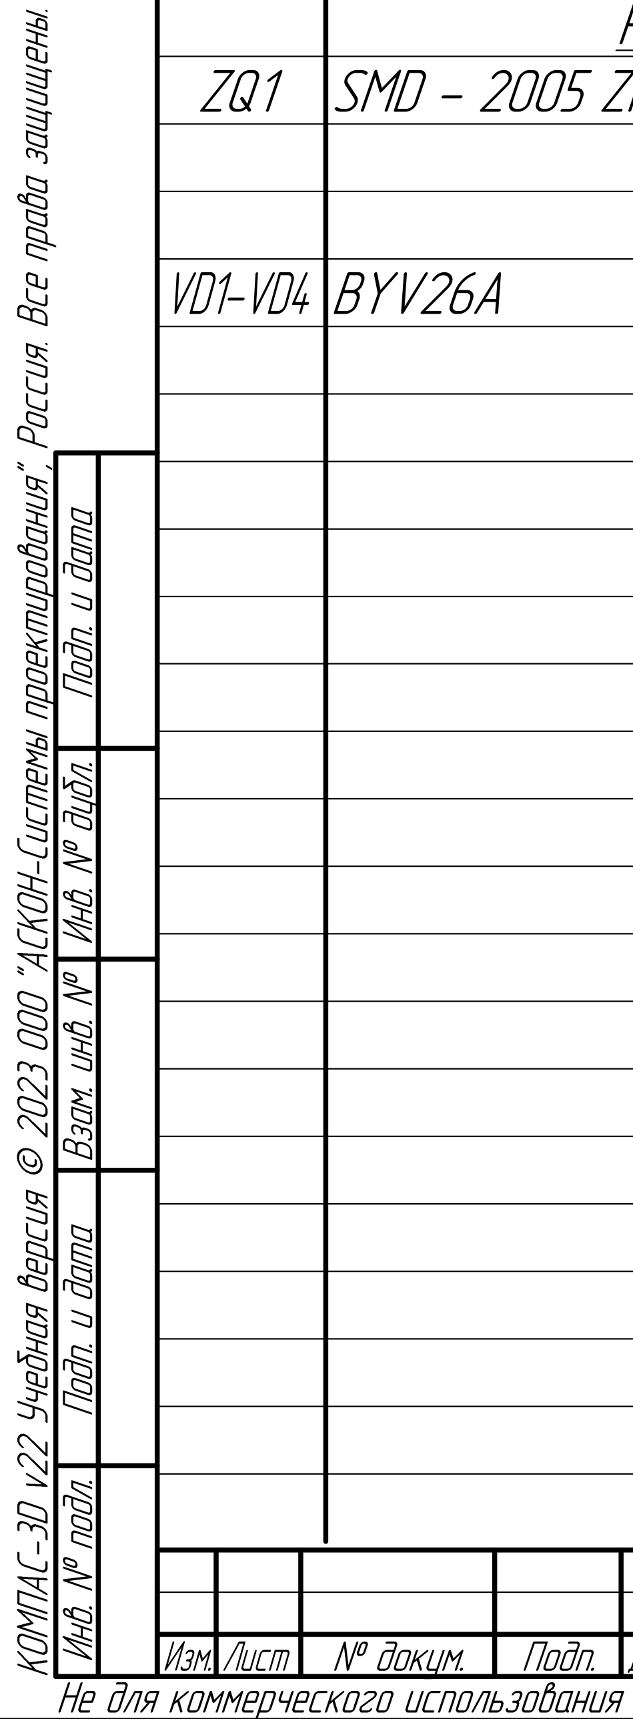
[picture p37: figure]

2 Инв. № подл. Подп. и дата Взам. инв. № Инв. № дубл. Подп. и дата | Изм. Лист | № докум. | Подп. | Дата
| Резонаторы
ZQ1 | SMD - 2005 ZM2012 32 кГц | 1
| Диоды
VD1-VD4 BYV26A | | 4
Поз. обозна-чение | Наименование | Кол. Примечание
| Микросхемы
DA1 | AD5160 | 1
DA2 | H11AA1 | 1
DA3 | AD7783 | 1
DA4 | ESP-12S | 1
DA5 | CH340 | 1
DA6, DA7 AD8510 | | 2
DA8 | ADG409 | 1
Копировал | Формат A4
