Niatomi/portable-phone-osciloscope/logseq/assets/image_1715509389826_0.png

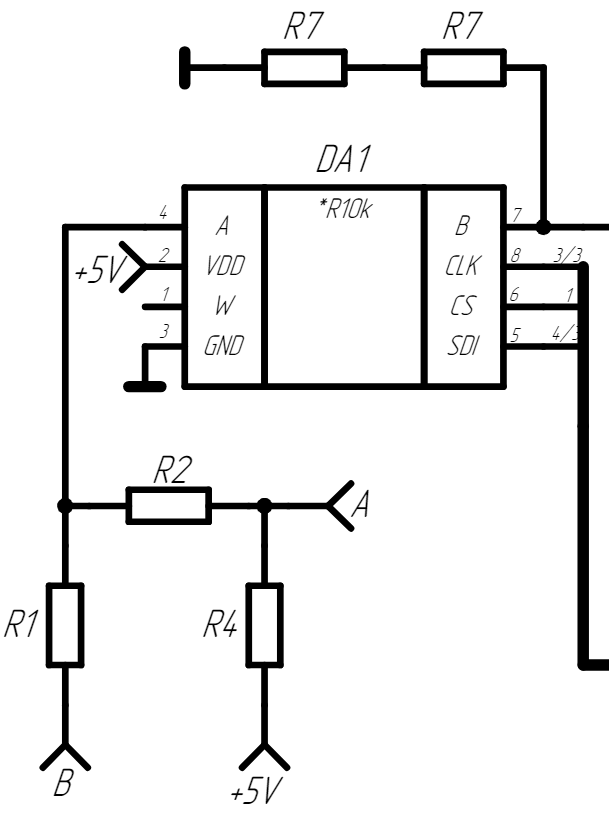
logseq/assets/image_1715509389826_0.png
