Niatomi/portable-phone-osciloscope/logseq/assets/image_1715513774334_0.png

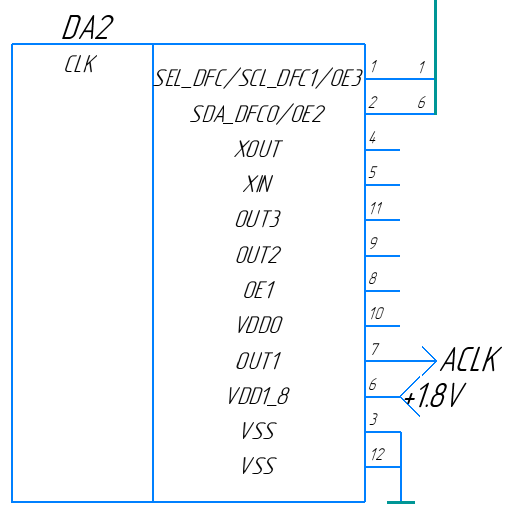
logseq/assets/image_1715513774334_0.png
