Niatomi/portable-phone-osciloscope/logseq/assets/image_1715516293544_0.png

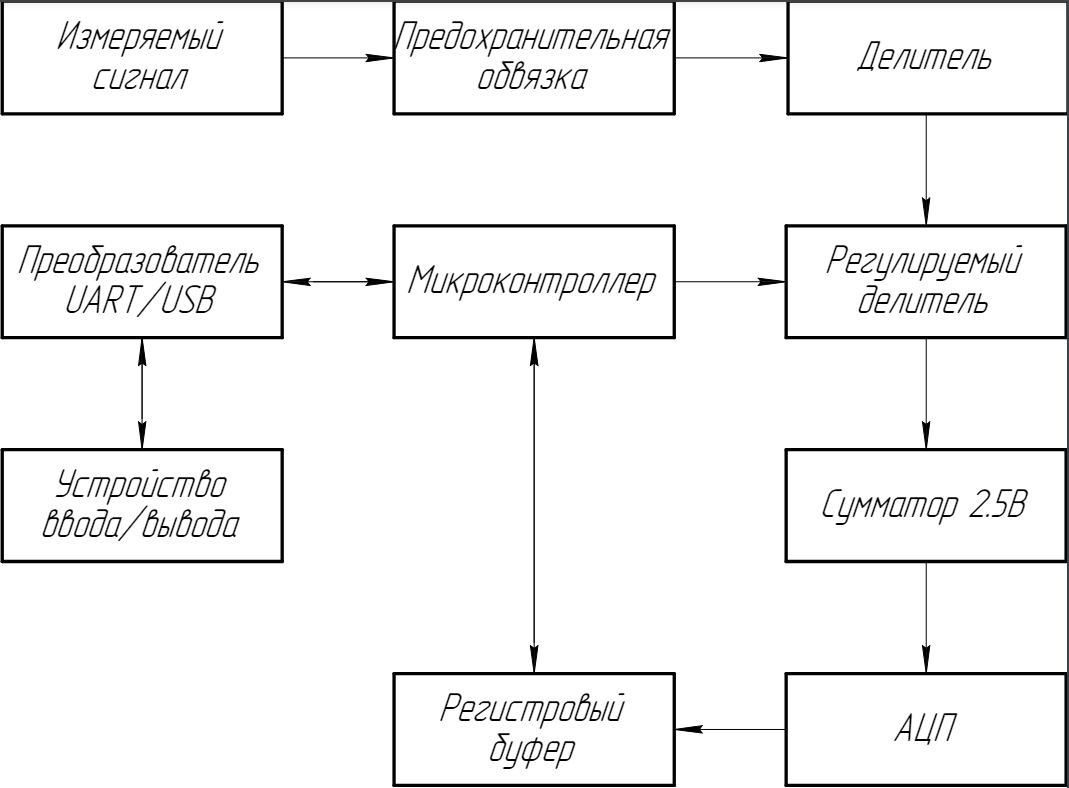
logseq/assets/image_1715516293544_0.png
