Niatomi/portable-phone-osciloscope/logseq/assets/image_1715708958198_0.png

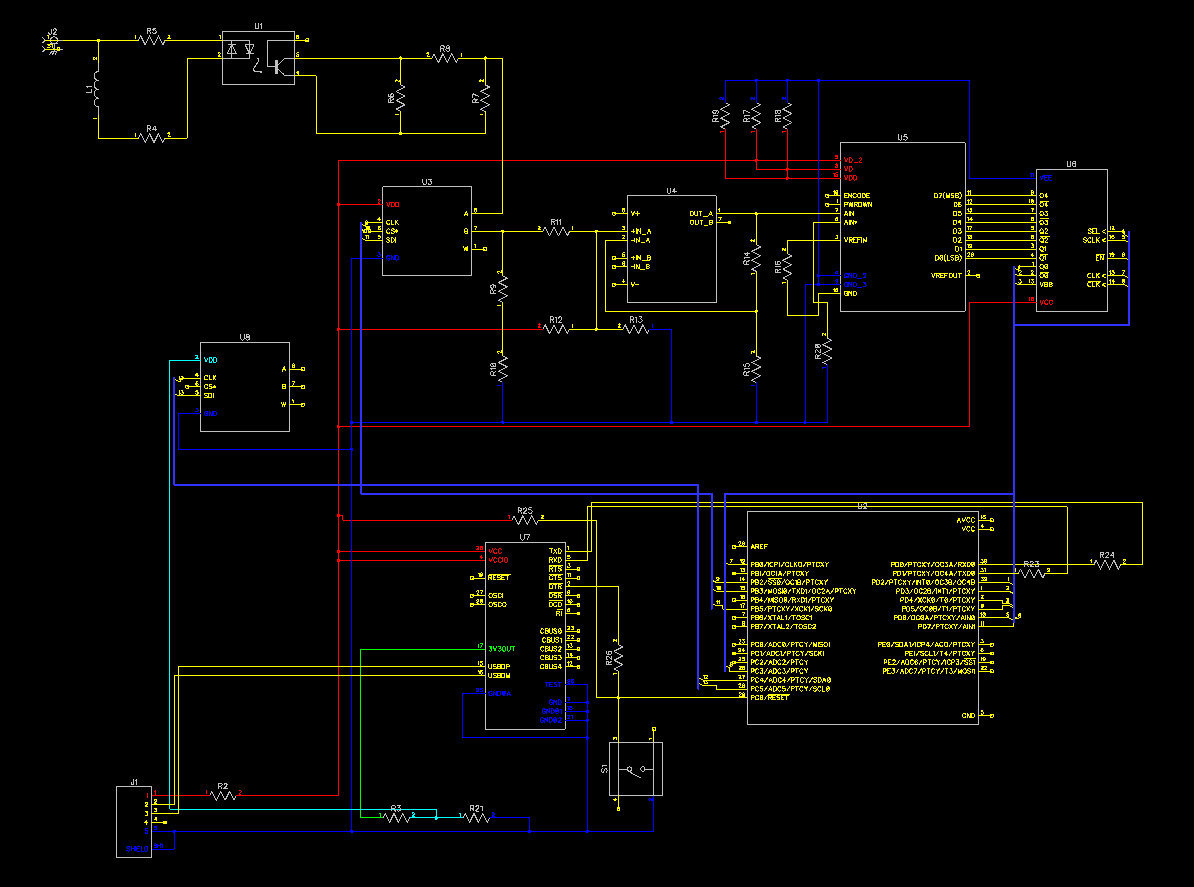
logseq/assets/image_1715708958198_0.png
