Niatomi/portable-phone-osciloscope/logseq/assets/image_1715934589543_0.png

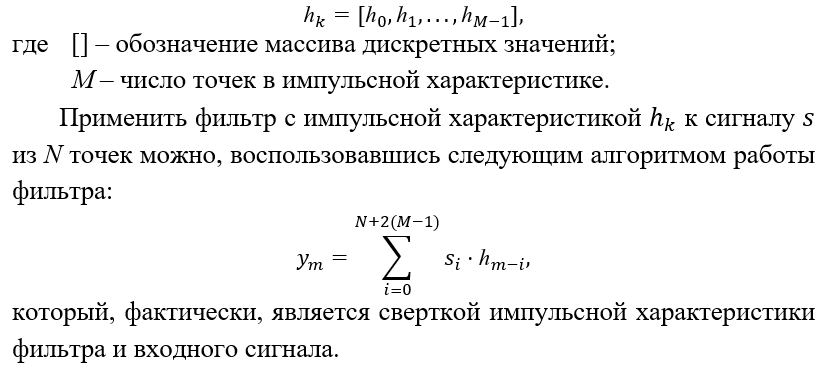
logseq/assets/image_1715934589543_0.png
