Niatomi/portable-phone-osciloscope/logseq/assets/image_1715935191469_0.png

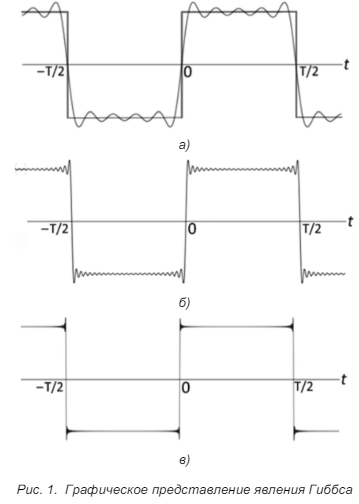
logseq/assets/image_1715935191469_0.png
