Niatomi/portable-phone-osciloscope/metrological-calculation/assets/vol-00.png

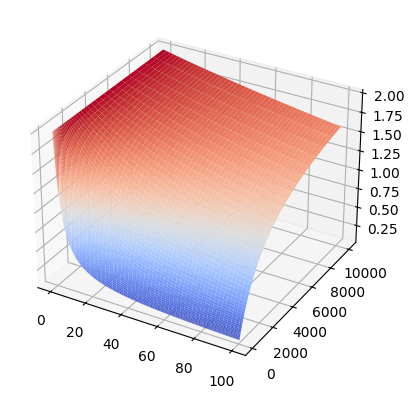
metrological-calculation/assets/vol-00.png
