Niatomi/portable-phone-osciloscope/metrological-calculation/assets/vol-01.png

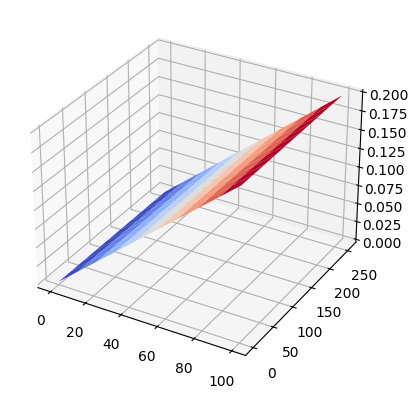
metrological-calculation/assets/vol-01.png
