Niatomi/portable-phone-osciloscope/metrological-calculation/assets/vol-02.png

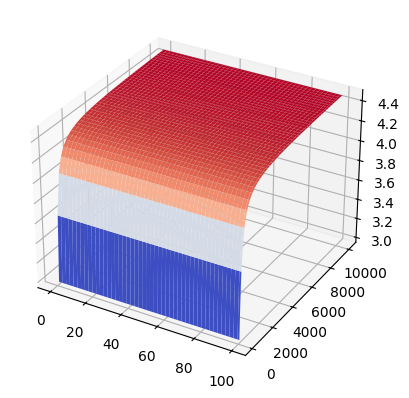
metrological-calculation/assets/vol-02.png
