Niatomi/portable-phone-osciloscope/бюрократия/ВКР/00-Даташыты/Упрощённая схема nano.webp

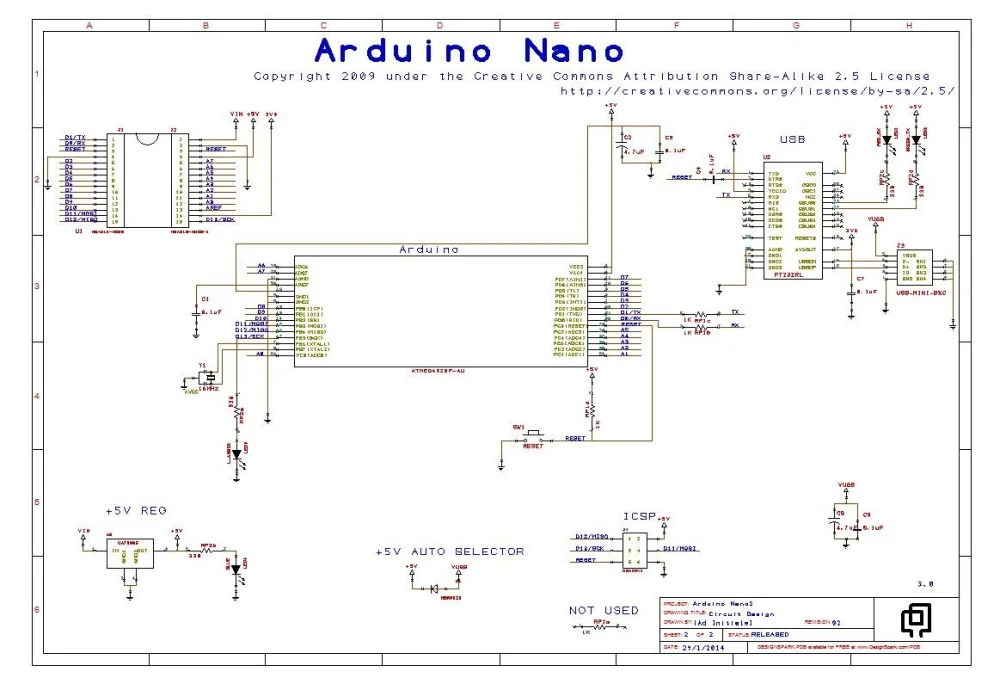
бюрократия/ВКР/00-Даташыты/Упрощённая схема nano.webp
