Niatomi/portable-phone-osciloscope/бюрократия/ВКР/01-Структурная схема/Структурная схема.png

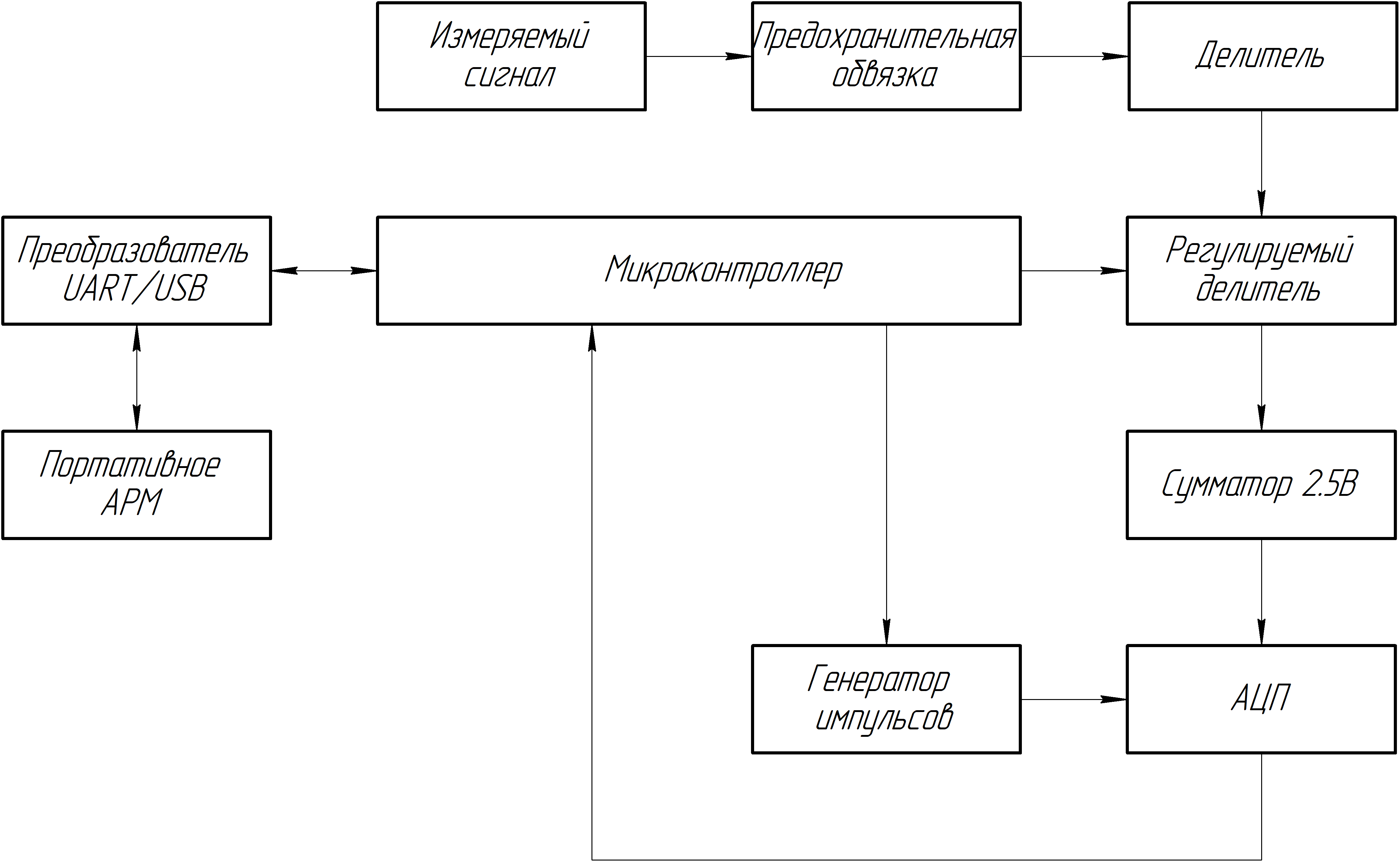
бюрократия/ВКР/01-Структурная схема/Структурная схема.png
