Niatomi/portable-phone-osciloscope/бюрократия/ВКР/04-Корпус/PCB___wctmp _ PCB___wctmp.png

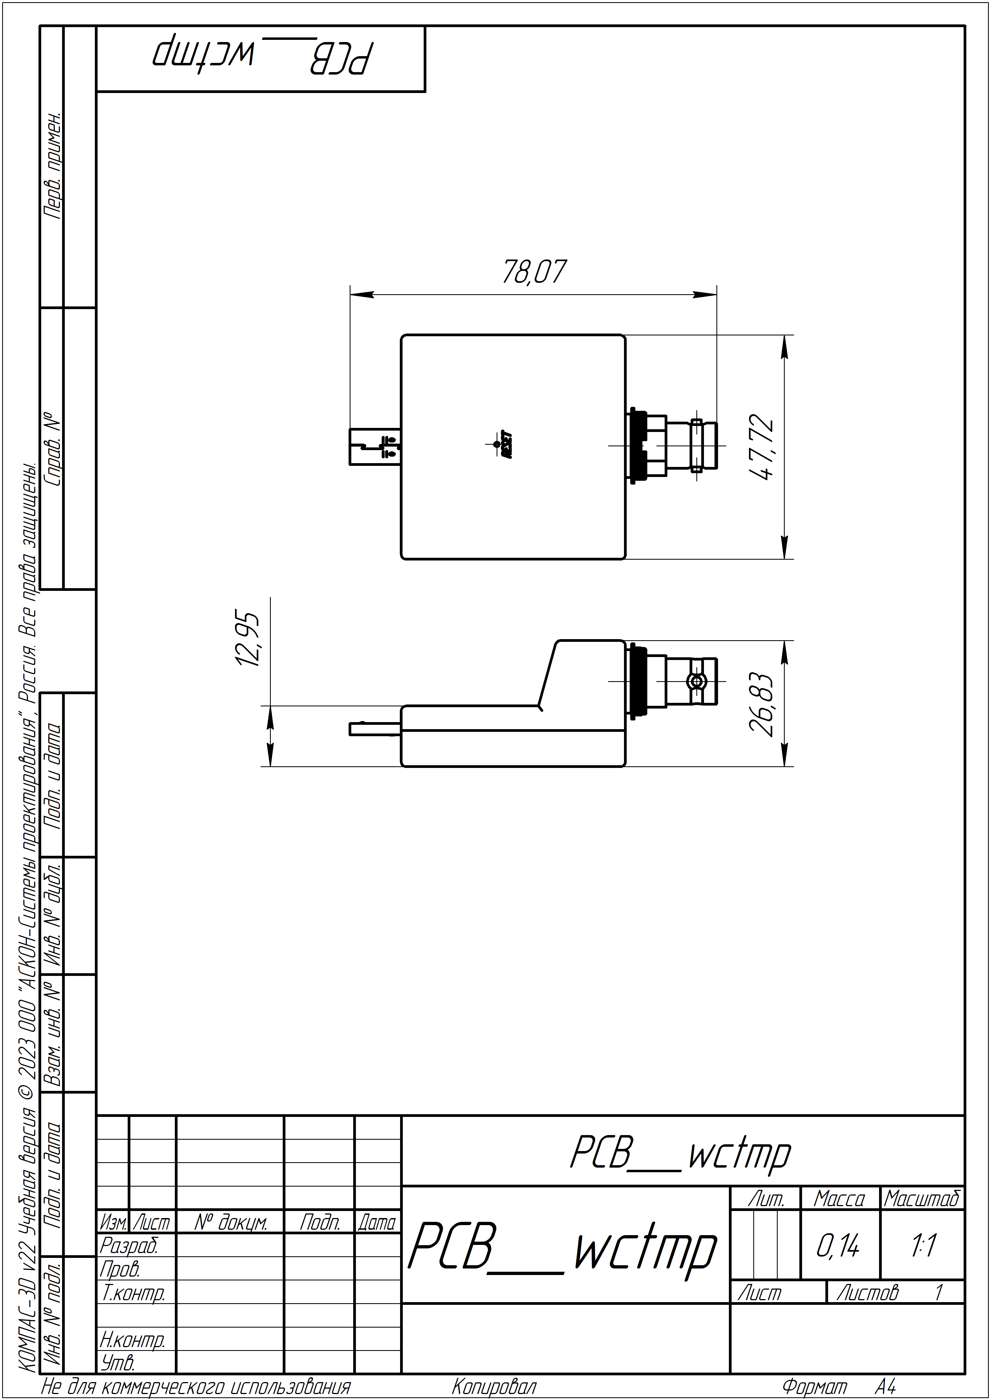
бюрократия/ВКР/04-Корпус/PCB___wctmp _ PCB___wctmp.png
