Niatomi/portable-phone-osciloscope/бюрократия/Курсовая/Даташыты/detektor_toka_220_v-4.jpg

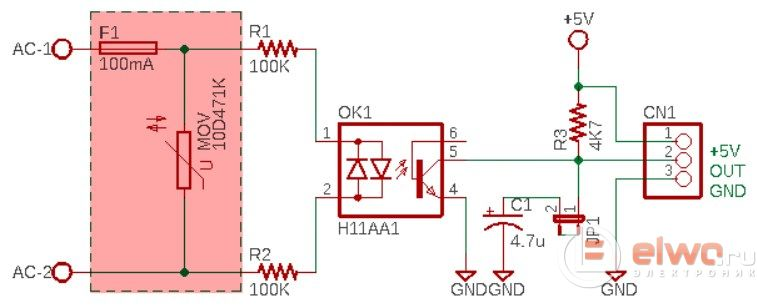
бюрократия/Курсовая/Даташыты/detektor_toka_220_v-4.jpg
