Niatomi/portable-phone-osciloscope/бюрократия/Курсовая/Фрагмент Спецификация.png

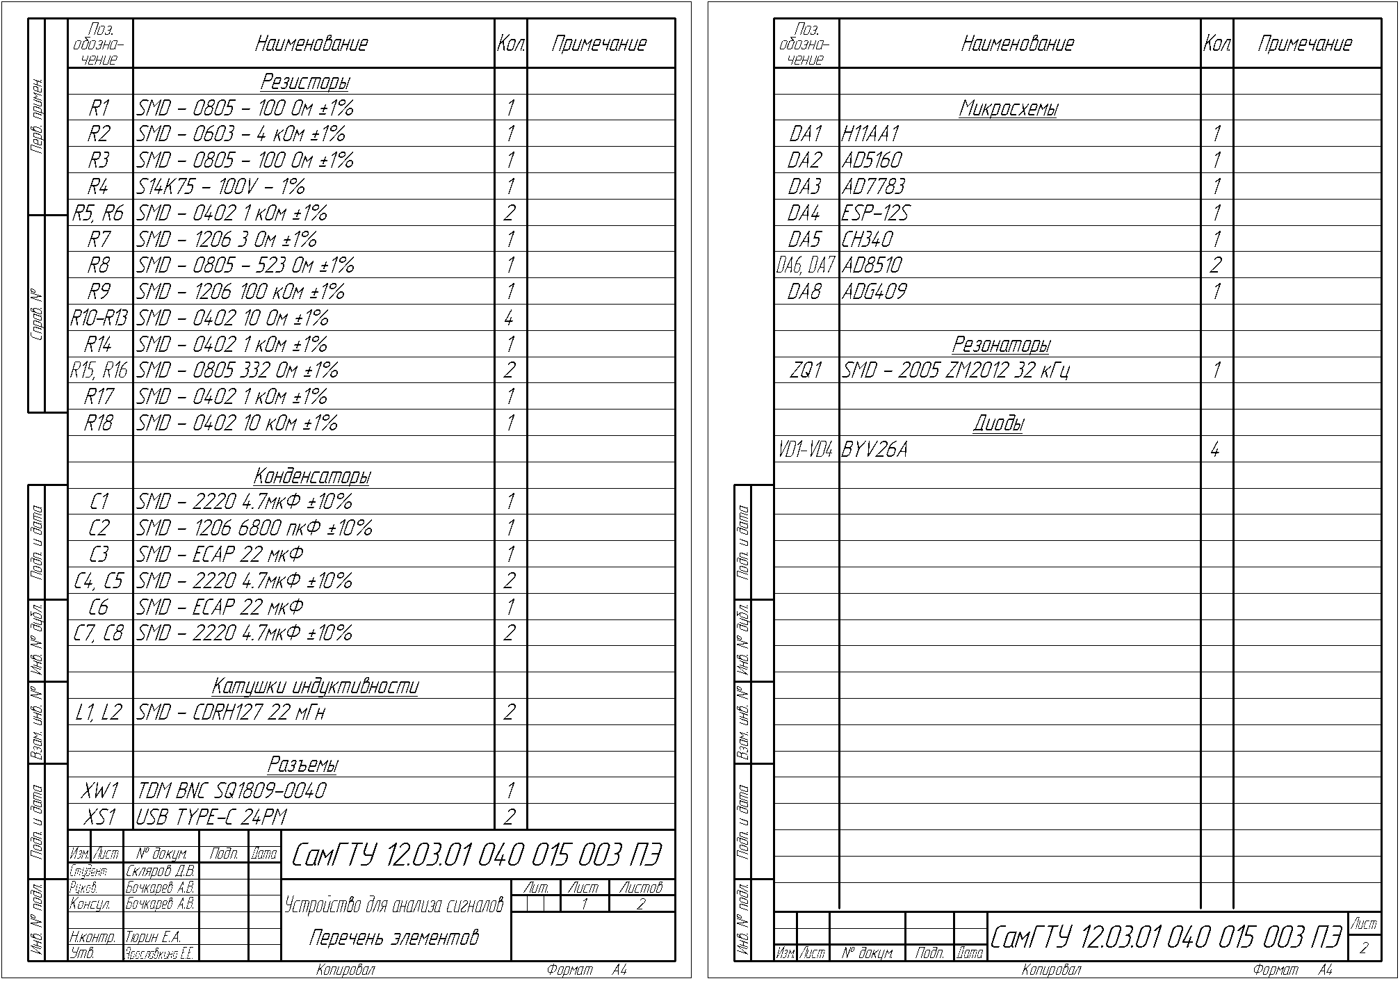
бюрократия/Курсовая/Фрагмент Спецификация.png
