Niatomi/portable-phone-osciloscope/бюрократия/Курсовая/Фрагмент.png

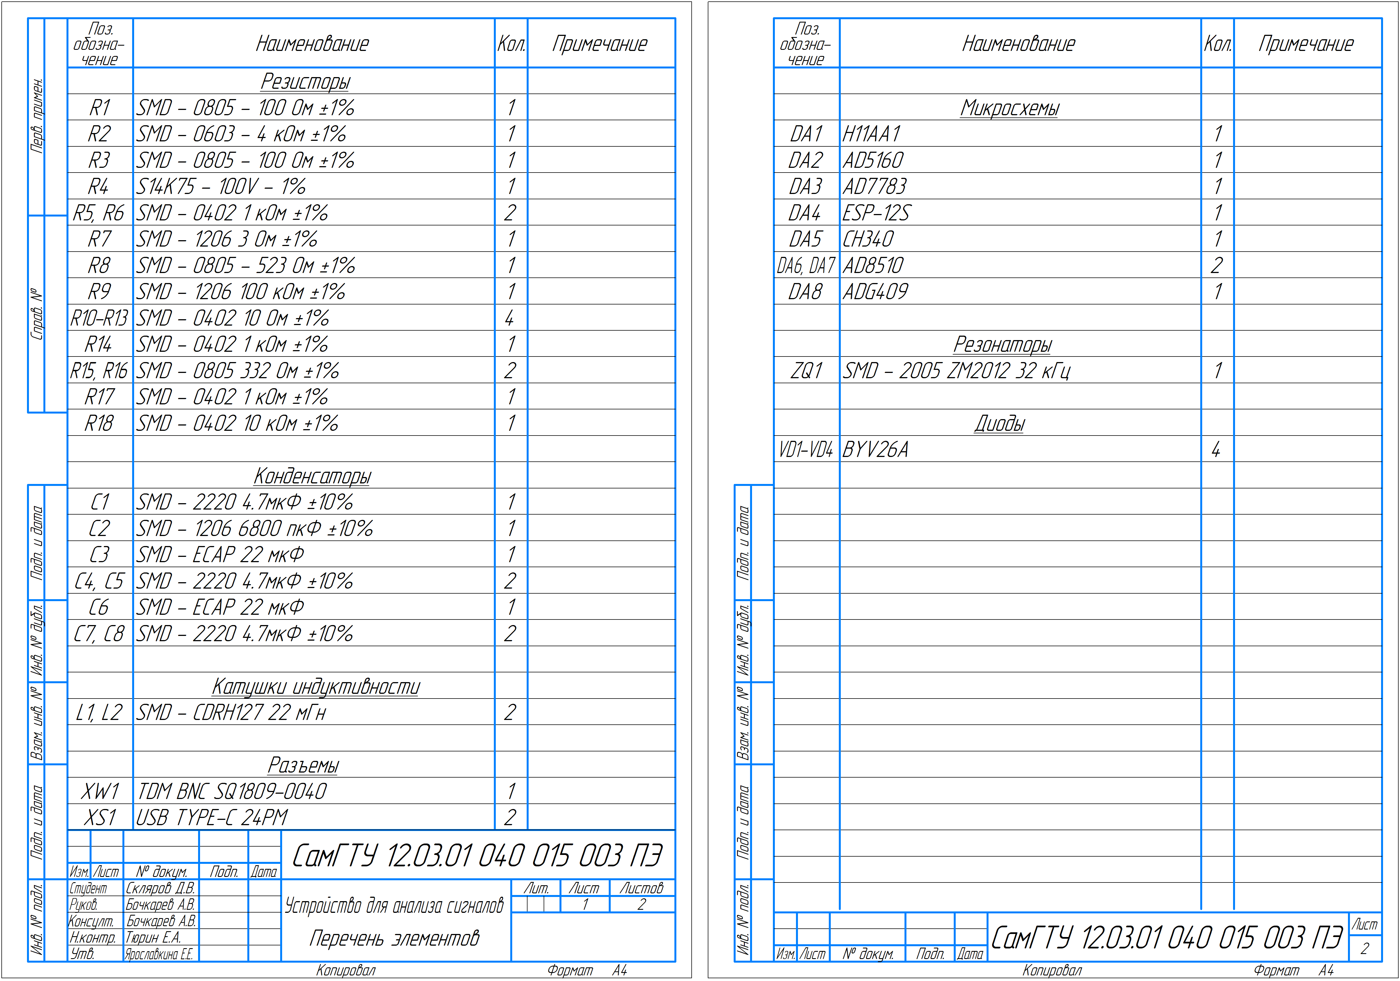
бюрократия/Курсовая/Фрагмент.png
