Niatomi/portable-phone-osciloscope/бюрократия/Курсовая/Функциональная схема.png

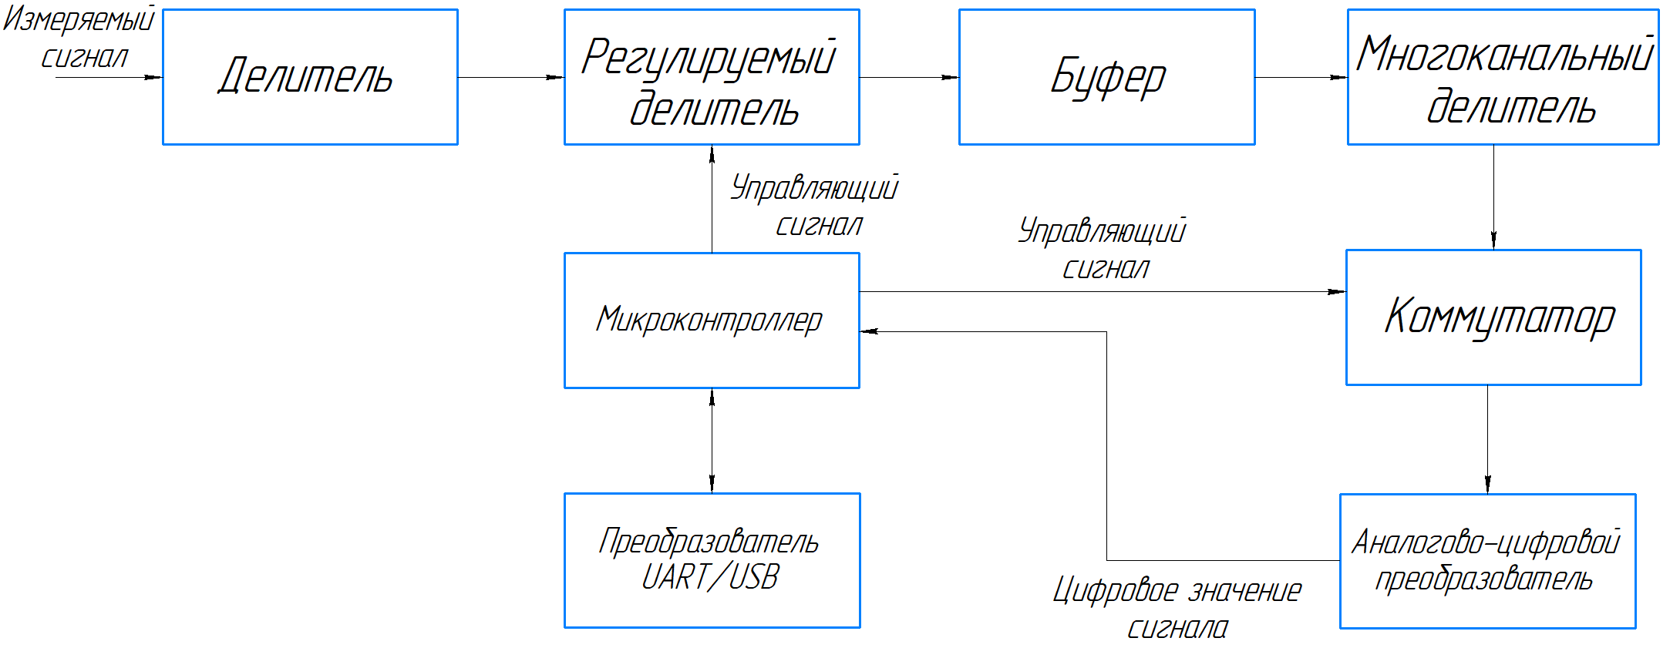
бюрократия/Курсовая/Функциональная схема.png
