Niatomi/portable-phone-osciloscope/бюрократия/ВКР/03-Печатная плата/3D/ESP-WROOM-32.step

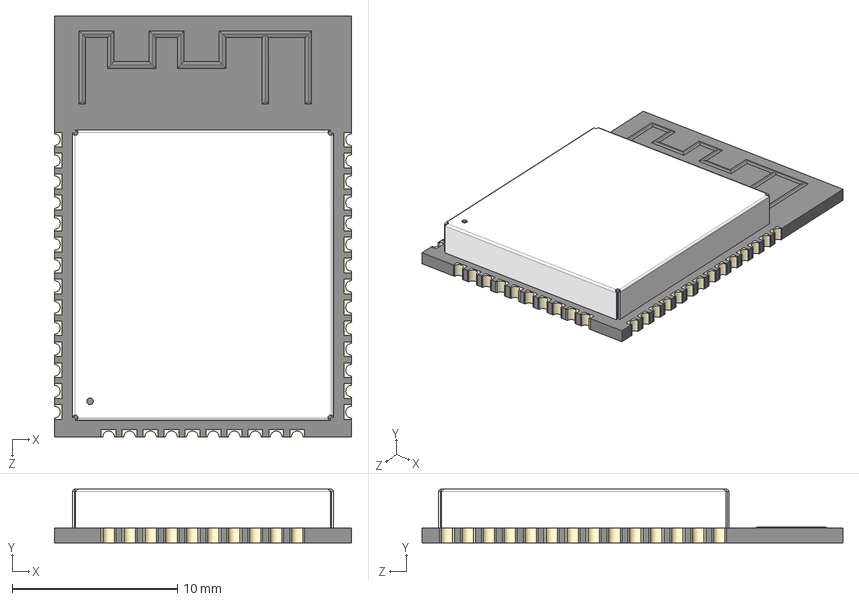
[picture p54: CAD file, 2024-05-21]
бюрократия/ВКР/03-Печатная плата/3D/ESP-WROOM-32.step
18.0 x 3.25 x 25.5 mm
