Niatomi/portable-phone-osciloscope/бюрократия/ВКР/03-Печатная плата/3D/FT232RL.step

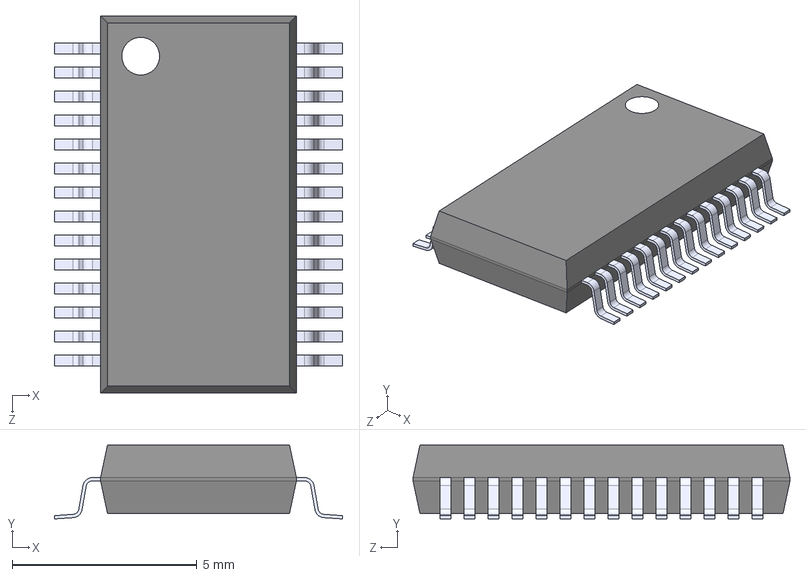
[picture p55: CAD file, 2024-05-14]
бюрократия/ВКР/03-Печатная плата/3D/FT232RL.step
7.80 x 2.00 x 10.2 mm
