Niatomi/portable-phone-osciloscope/бюрократия/ВКР/03-Печатная плата/3D/AD9283BRSZ-50.step

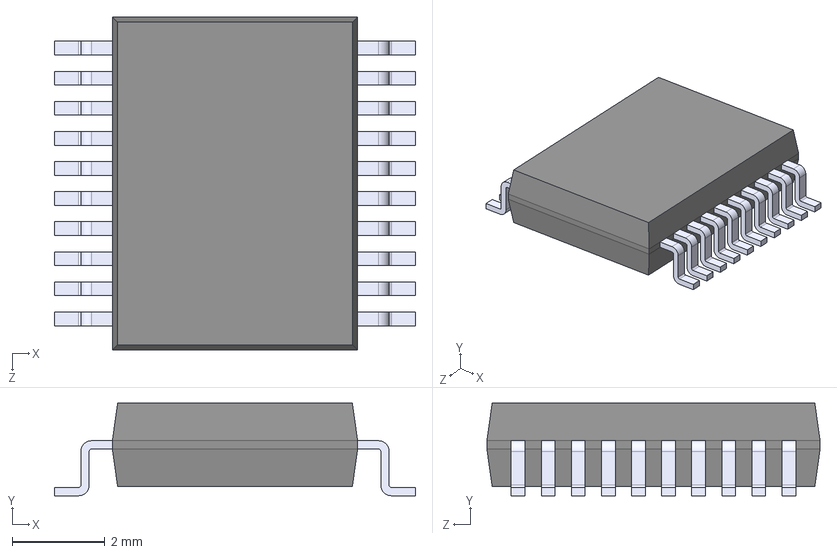
[picture p56: CAD file, 2024-05-14]
бюрократия/ВКР/03-Печатная плата/3D/AD9283BRSZ-50.step
7.80 x 2.00 x 7.20 mm
