Niatomi/portable-phone-osciloscope/бюрократия/ВКР/03-Печатная плата/3D/UJ2-MIBH-4-SMT.step

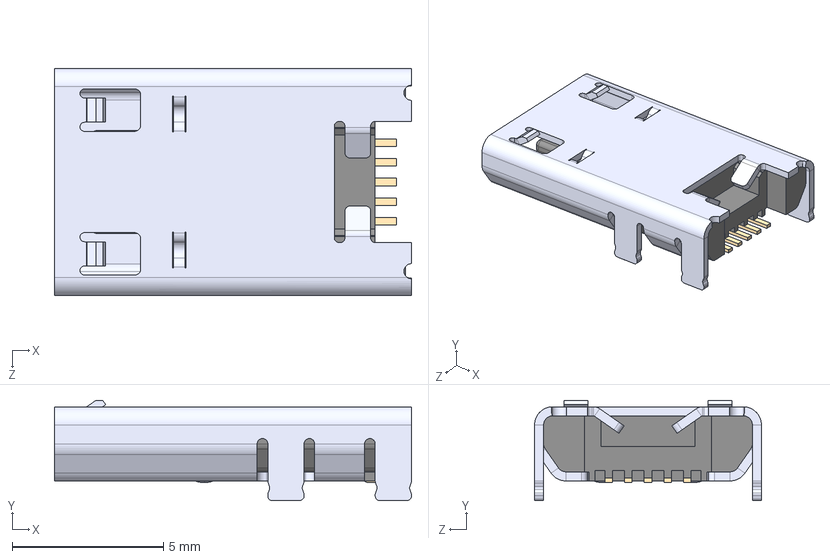
[picture p57: CAD file, 2024-05-14]
бюрократия/ВКР/03-Печатная плата/3D/UJ2-MIBH-4-SMT.step
11.8 x 3.31 x 7.50 mm
