Niatomi/portable-phone-osciloscope/бюрократия/ВКР/03-Печатная плата/3D/AD8512ARMZ.step

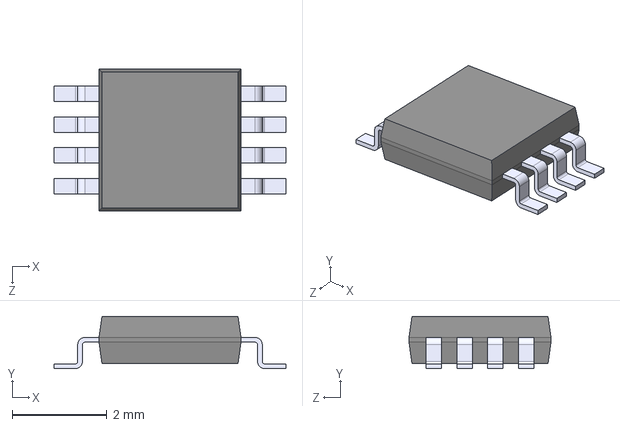
[picture p58: CAD file, 2024-05-14]
бюрократия/ВКР/03-Печатная плата/3D/AD8512ARMZ.step
4.90 x 1.10 x 3.00 mm
