Niatomi/portable-phone-osciloscope/бюрократия/ВКР/03-Печатная плата/3D/FT234XD-R.step

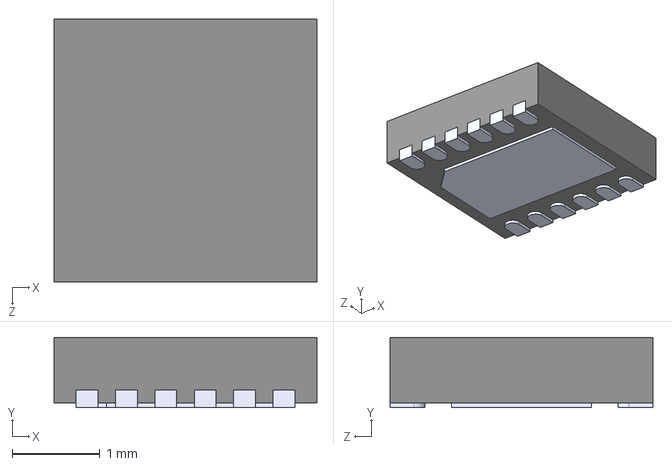
[picture p59: CAD file, 2024-05-14]
бюрократия/ВКР/03-Печатная плата/3D/FT234XD-R.step
3.00 x 0.8 x 3.00 mm
