Niatomi/portable-phone-osciloscope/бюрократия/ВКР/03-Печатная плата/3D/AD5160BRJZ5-RL7.step

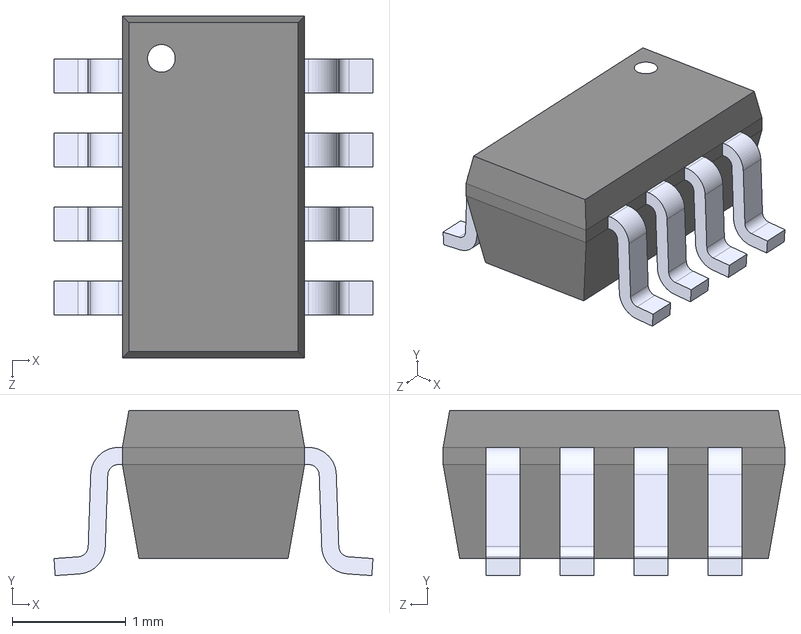
[picture p60: CAD file, 2024-05-14]
бюрократия/ВКР/03-Печатная плата/3D/AD5160BRJZ5-RL7.step
2.80 x 1.45 x 3.00 mm
