Niatomi/portable-phone-osciloscope/бюрократия/ВКР/03-Печатная плата/3D/TS02-66-95-BK-260-LCR-D.step

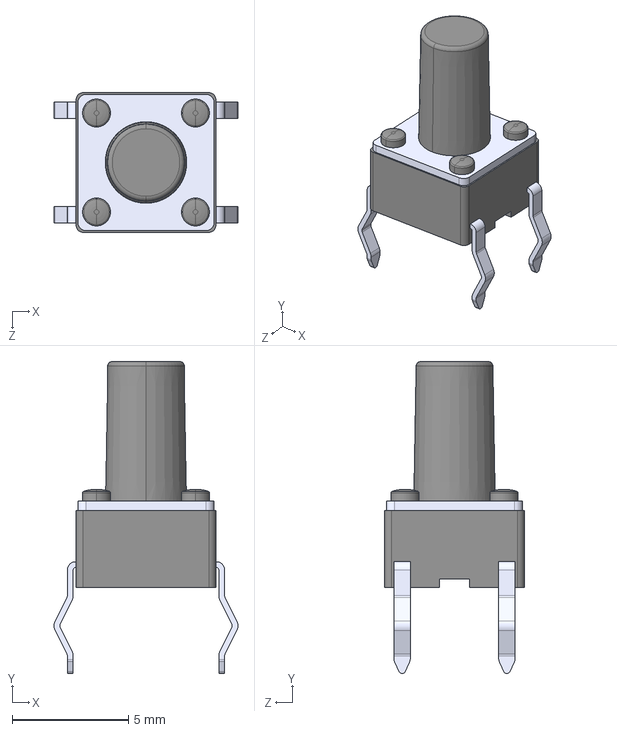
[picture p61: CAD file, 2024-05-14]
бюрократия/ВКР/03-Печатная плата/3D/TS02-66-95-BK-260-LCR-D.step
7.90 x 13.4 x 6.00 mm
