Niatomi/portable-phone-osciloscope/бюрократия/ВКР/03-Печатная плата/3D/ATMEGA328PB-MU.step

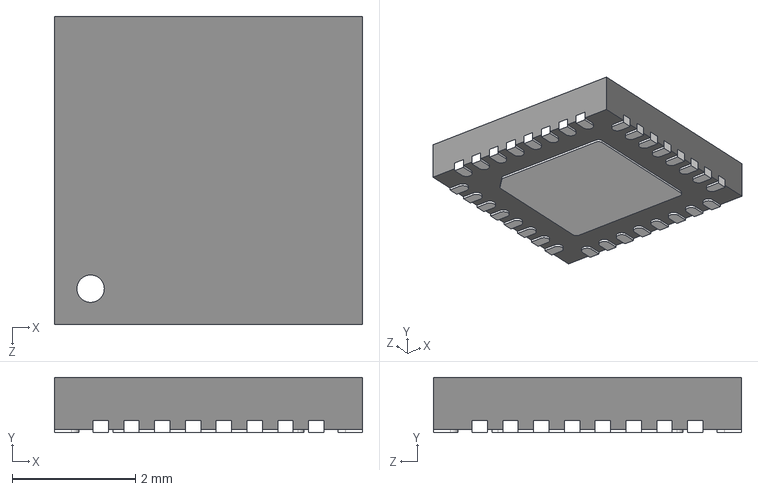
[picture p62: CAD file, 2024-05-14]
бюрократия/ВКР/03-Печатная плата/3D/ATMEGA328PB-MU.step
5.00 x 0.9 x 5.00 mm
