Niatomi/portable-phone-osciloscope/бюрократия/ВКР/03-Печатная плата/3D/MAX9316EWP.step

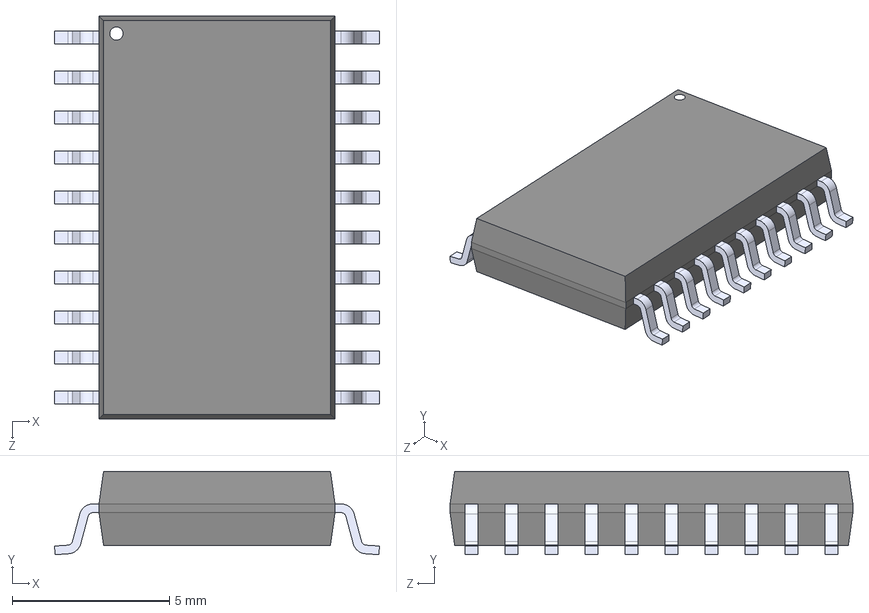
[picture p63: CAD file, 2024-05-14]
бюрократия/ВКР/03-Печатная плата/3D/MAX9316EWP.step
10.3 x 2.65 x 12.8 mm
