Niatomi/portable-phone-osciloscope/бюрократия/ВКР/03-Печатная плата/3D/H11AA1-X009.step

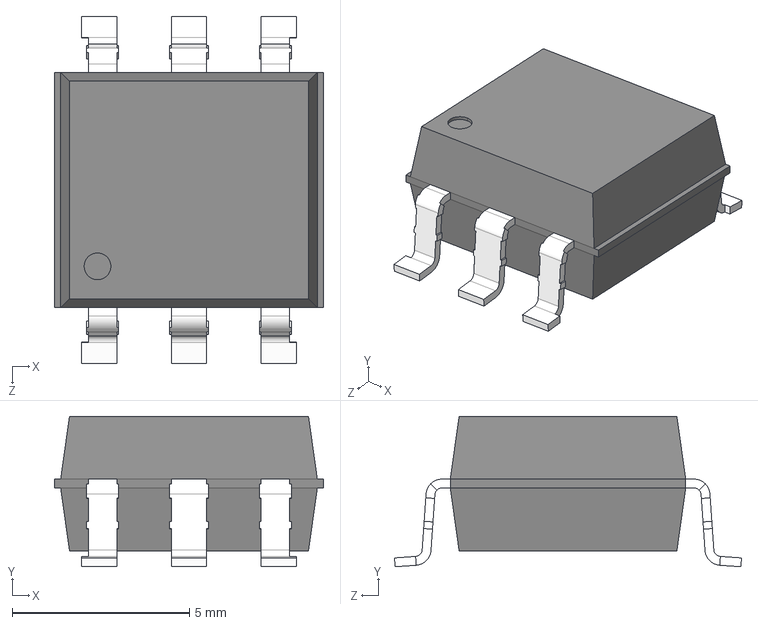
[picture p64: CAD file, 2024-05-14]
бюрократия/ВКР/03-Печатная плата/3D/H11AA1-X009.step
7.60 x 4.25 x 9.80 mm
