Niatomi/portable-phone-osciloscope/бюрократия/ВКР/03-Печатная плата/3D/BNC7T-J-P-HN-RA-BH1.step

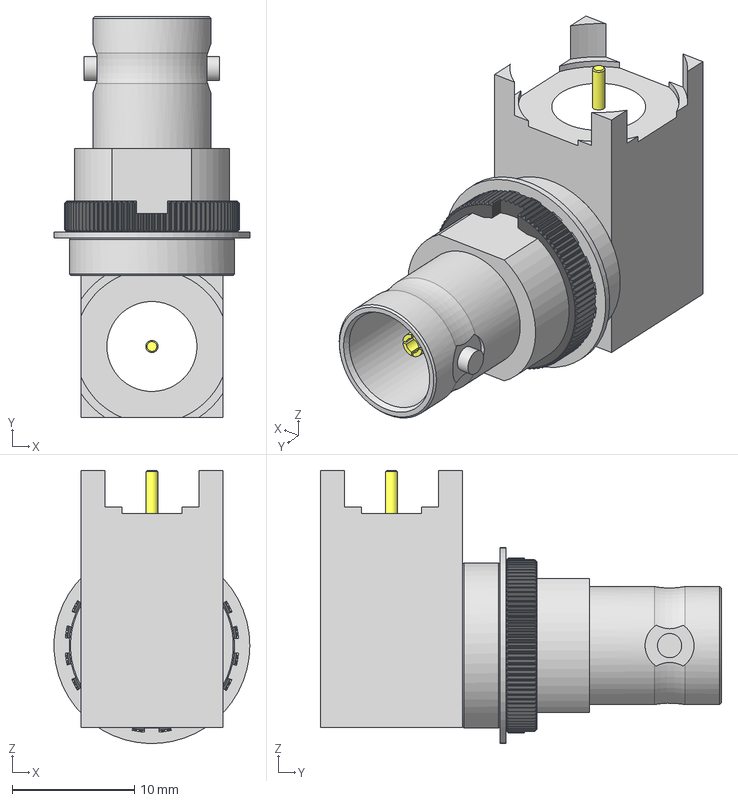
[picture p65: CAD file, 2024-05-14]
бюрократия/ВКР/03-Печатная плата/3D/BNC7T-J-P-HN-RA-BH1.step
16.0 x 32.8 x 22.3 mm
BNC7T-G-P-HN-RA-BH1_s
BNC7T-G-P-HN-RA-BH1_i
BNC7T-G-P-HN-RA-BH1_p
BNC7T-G-P-HN-RA-BH1_w
BNC7T-G-P-HN-RA-BH1_n
