Niatomi/portable-phone-osciloscope/бюрократия/ВКР/03-Печатная плата/3D/B82422A3820K108.step

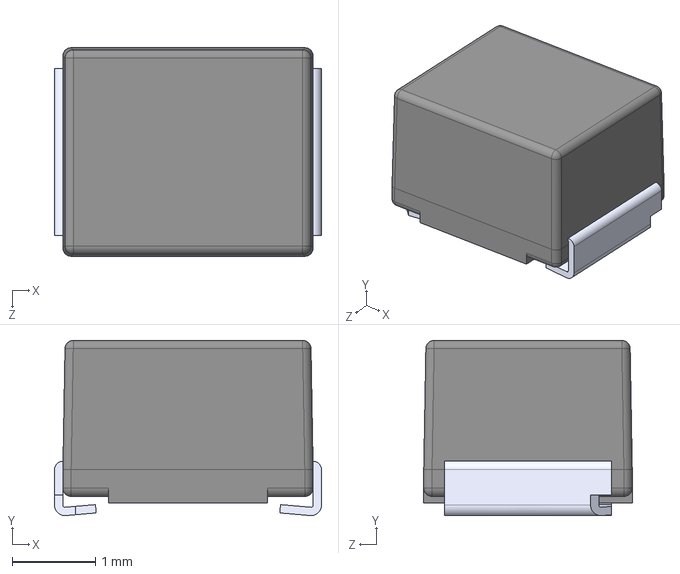
[picture p66: CAD file, 2024-05-14]
бюрократия/ВКР/03-Печатная плата/3D/B82422A3820K108.step
3.20 x 2.10 x 2.50 mm
