Niatomi/portable-phone-osciloscope/бюрократия/ВКР/01-Структурная схема/Структурная схема.pdf

## 5 DA1

+5V

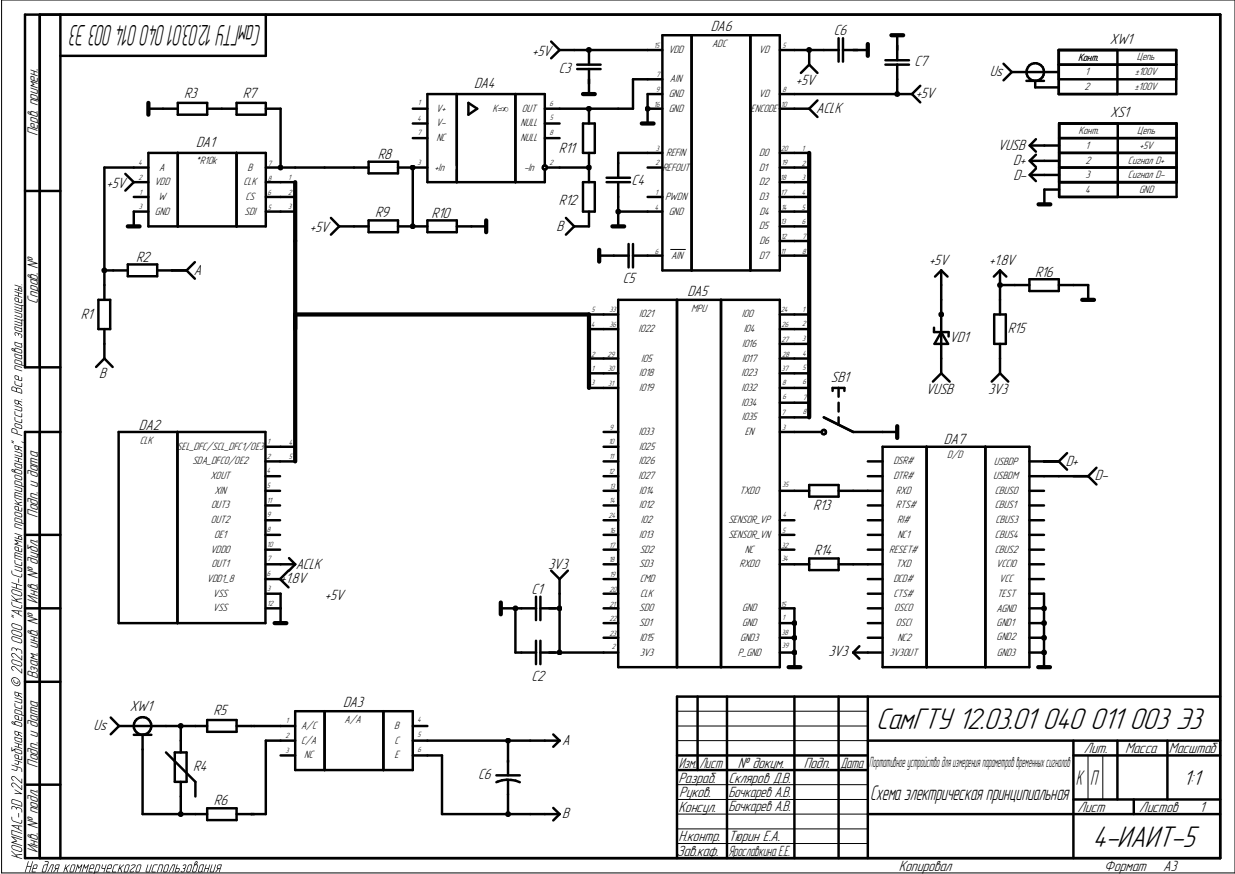
[picture p67: page 1]

AIN GND GND REFIN REFOUT PWDN GND AIN | ADC | VD VD ENCODE D0 D1 D2 D3 D4 D5 D6 D7

4-ИАИТ-5 Инв. № подл. Подп. и дата Взам. инв. № Инв. № дубл. Подп. и дата Справ. № Перв. примен.

IO22 ⁴ | 26 2
2 29 | | 27 3

1 30 | 37 5
3 31 | 6

СамГТУ 12.03.01 040 011 003 Э3

Портативное устройство для измерения параметров временных сигналов Схема электрическая принципиальная | Лит. | Масса | Масштаб

Изм. Лист | | № докум. | Подп. | Дата | | К П | | | 1:1
Разраб. | | Скляров Д.В.
Руков. | | Бочкарев А.В.
Консул. | Бочкарев А.В. | | | | Лист | Листов 1

Н.контр. | Тюрин Е.А.
Зав.каф. | Ярославкина Е.Е.
