Niatomi/portable-phone-osciloscope/бюрократия/ВКР/04-Корпус/Габариты.pdf

69,39

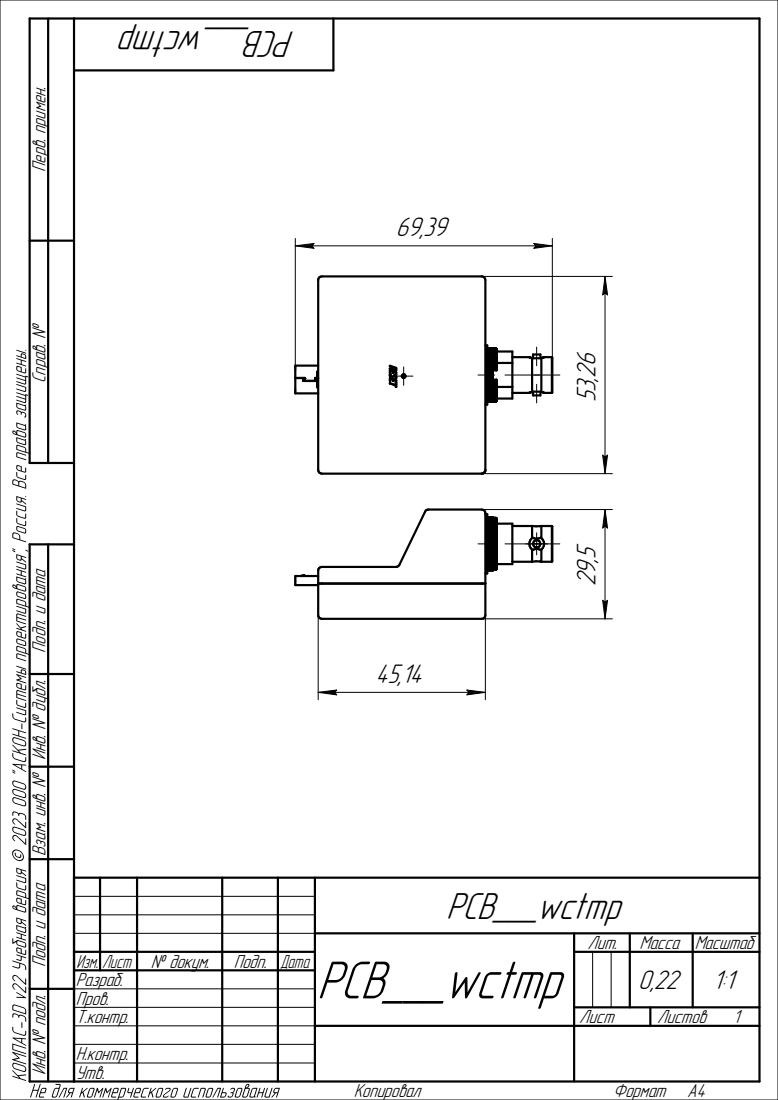
[picture p68: page 1]
Копировал; Формат A4

0,22 Инв. № подл. Подп. и дата Взам. инв. № Инв. № дубл. Подп. и дата Справ. № Перв. примен.

PCB___wctmp

PCB___wctmp | Лит. | Масса | Масштаб

Изм. Лист | № докум. | Подп. | Дата | | | | | 1:1
Разраб.
Пров.
Т.контр. | | | | Лист | Листов 1
Н.контр.
Утв.
