Niatomi/portable-phone-osciloscope/бюрократия/ВКР/03-Печатная плата/123.pdf

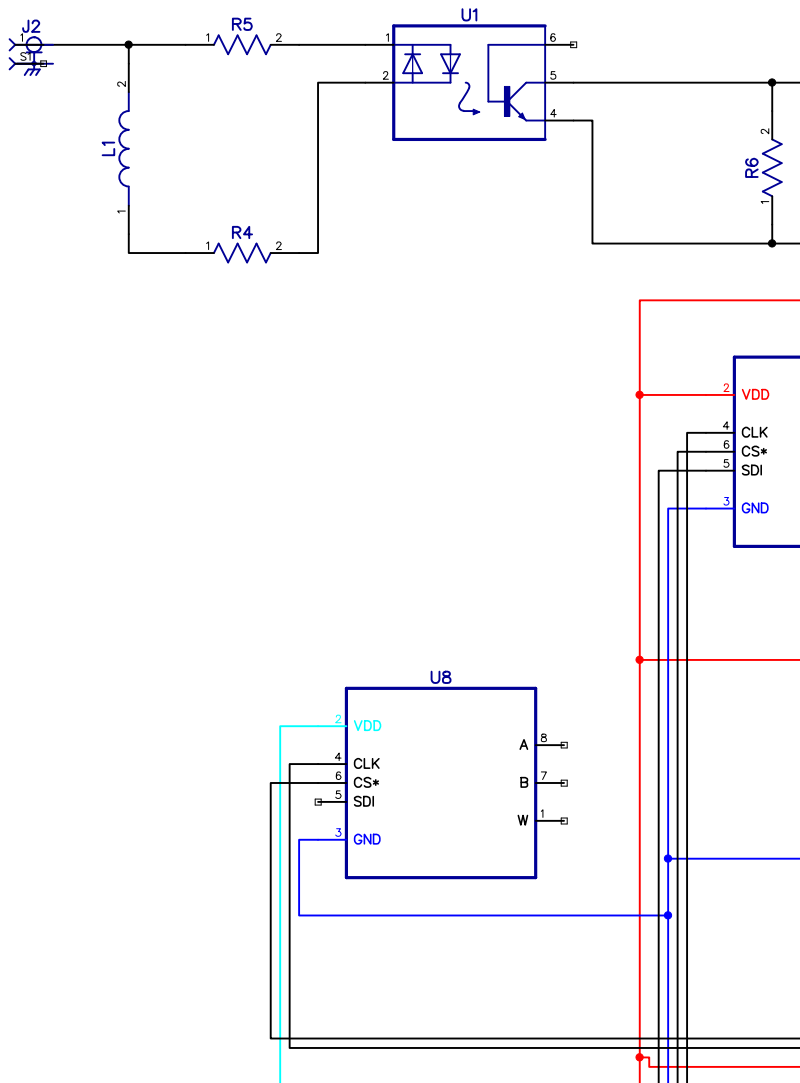
[picture p69: page 1]
