Niatomi/portable-phone-osciloscope/бюрократия/ВКР/03-Печатная плата/Печатная плата.pdf

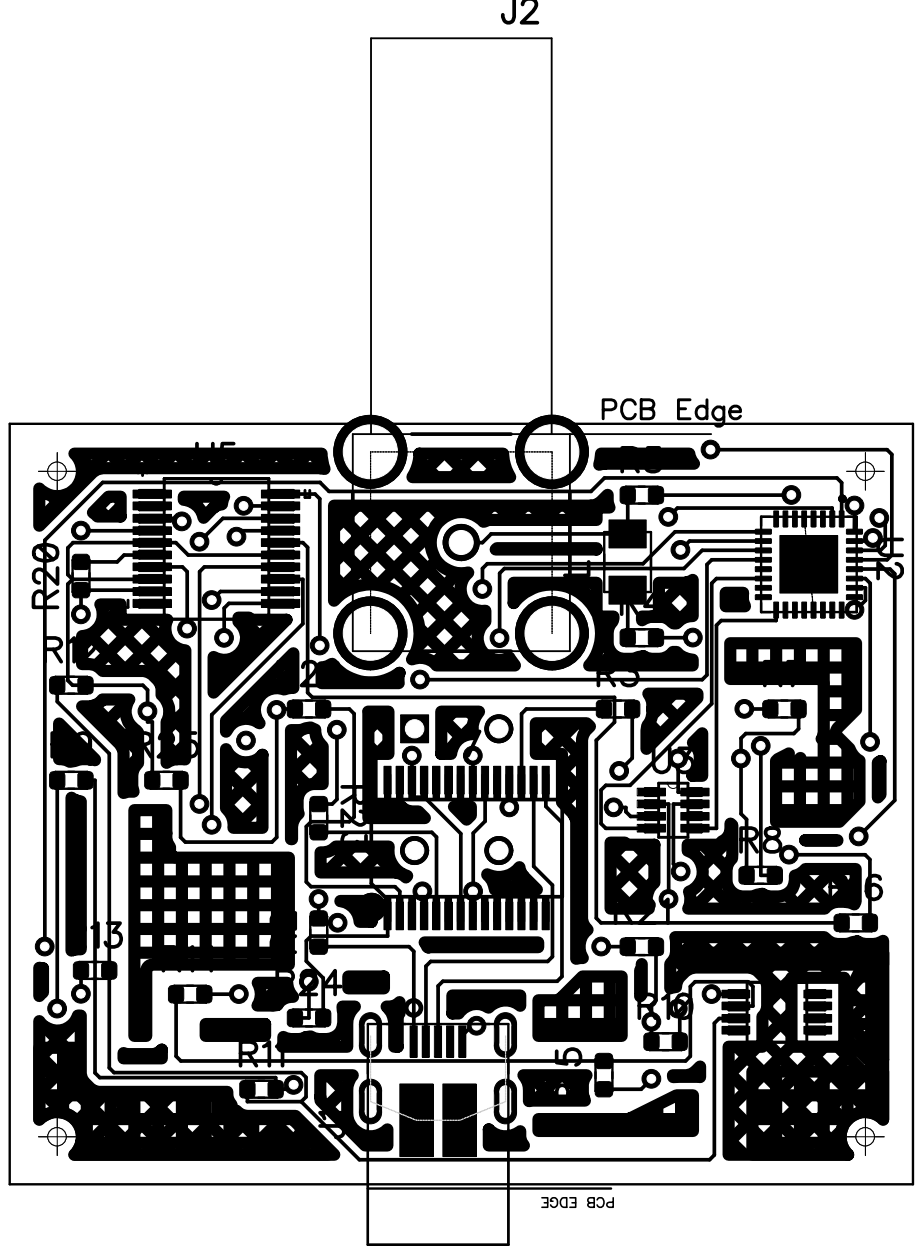
[picture p70: page 1]
