Niatomi/portable-phone-osciloscope/(list of files, drawings)

Other design files:
бюрократия/ВКР/03-Печатная плата/esp.dip
бюрократия/ВКР/03-Печатная плата/Плата.dip
бюрократия/ВКР/03-Печатная плата/Принципиалка.dch
