Niatomi/portable-phone-osciloscope/(commit log)

2023-12-02 Da poebat' mne
    [Инструментальная погрешность.xlsx]
2024-02-10 Changed folder name
    [Инструментальная погрешность.xlsx]
2024-05-07 Implemented base ground for nano code
2024-05-07 Implemented byte frame parser
2024-05-07 Add activity for my device
2024-05-11 Documentation upd
    [Инструментальная погрешность.xlsx]
2024-05-14 Work update
    [AD5160BRJZ5-RL7.step, AD8512ARMZ.step, AD9283BRSZ-50.step, ATMEGA328PB-MU.step, B82422A3820K108.step, BNC7T-J-P-HN-RA-BH1.step, FT232RL.step, FT234XD-R.step]
2024-05-14 Created holder for plate
2024-05-17 Time to die i guess...
2024-05-21 Docs update
    [ESP-WROOM-32.step, esp.dip, Принципиалка.dch]
2024-05-23 Add counting of voltage inaccuracy
