Niatomi/portable-phone-osciloscope/(notices)

Notices in the files:
бюрократия/ВКР/03-Печатная плата/3D/BNC7T-J-P-HN-RA-BH1.step:
author */ ('License CC BY-ND 4.0'),
